mossblaser/makebed/doc/images/testCube.jpg

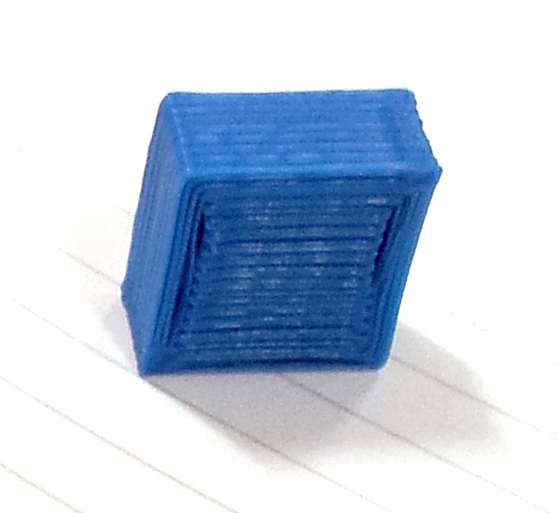
doc/images/testCube.jpg
