mossblaser/makebed/doc/images/testCubeRepg.png

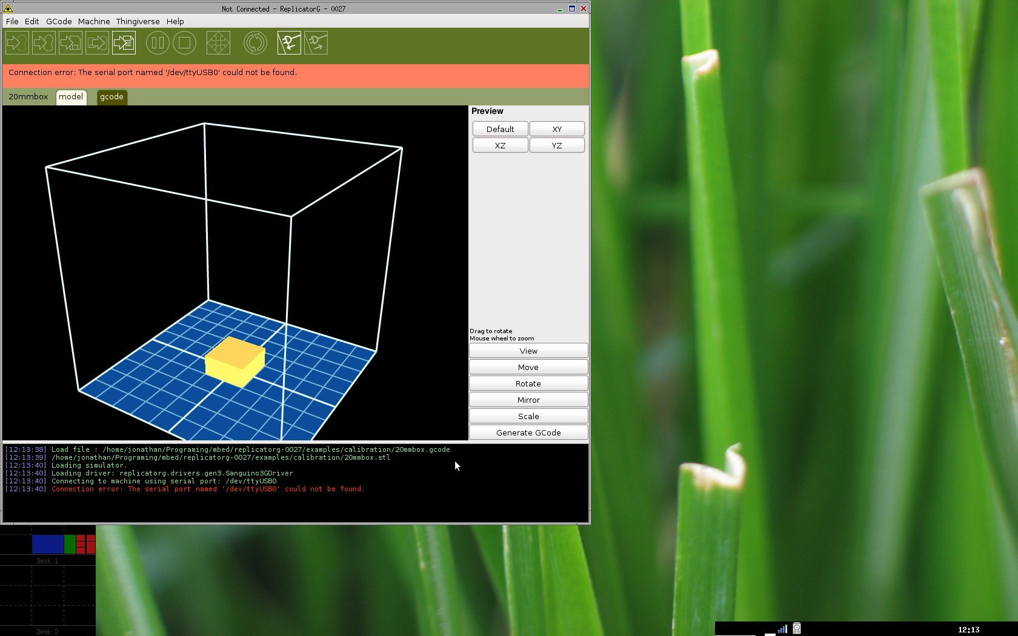
doc/images/testCubeRepg.png
