mossblaser/makebed/doc/diagrams/electronicsDiagram.pdf

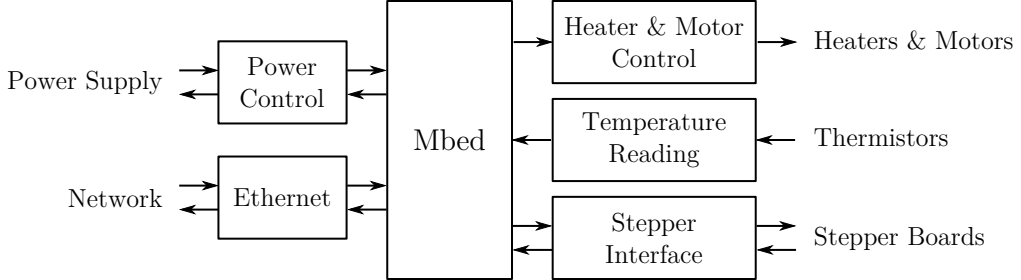
[picture p3: figure]
Mbed; Heater & Motor Control; Temperature Reading; Stepper Interface; Ethernet; Power Control; Power Supply; Network; Heaters & Motors; Thermistors; Stepper Boards
