mossblaser/makebed/doc/diagrams/electronicsPhoto.pdf

ATX Power Supply

Stepper Controller (Z)

Stepper Controller (Y)

Stepper Controller (X)

Ethernet Interface

Programmer Interface

Stop/Reset Button

To Heaters/Motors

To Thermistors

End-stop Board

To End-stops

End-stop Interface

To PSU

Main Board
