mossblaser/makebed/doc/diagrams/datagram.pdf

(UDP Header)

To Printer: | (UDP Header) | Sequence No.
From Printer: | Sequence No. | Window Size Payload (G-code)
