mossblaser/makebed/doc/diagrams/extruder.pdf

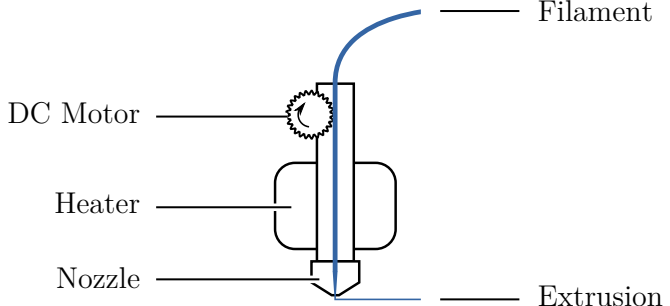
[picture p4: figure]
Filament; DC Motor; Heater; Nozzle; Extrusion
