mossblaser/makebed/doc/diagrams/jackMagnetics.pdf

(A) Without Magnetics | (B) With Magnetics
