mossblaser/makebed/doc/diagrams/mainBoard.pdf

Reserved For
Future Use

Low-Power
Area

High-Power
Area

Passive External
Connections
