mossblaser/makebed/doc/diagrams/stepperControllerBoard.pdf

End-stops

Stepper Motor

TTL Interface

Power
