mossblaser/makebed/doc/diagrams/systemDiagramFirmware.pdf

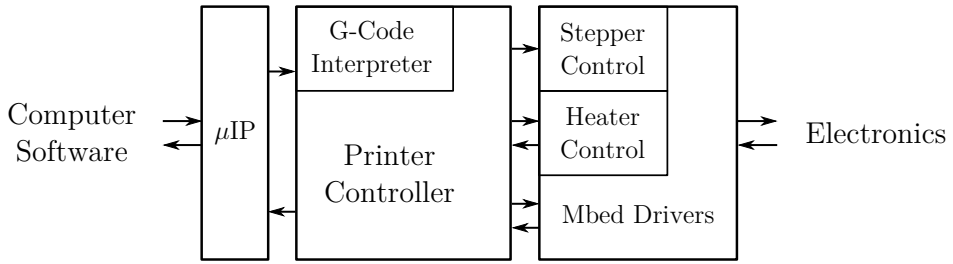
[picture p5: figure]
Printer Controller; G-Code Interpreter; µIP; Mbed Drivers; Stepper Control; Heater Control; Computer; Software; Electronics
