mossblaser/makebed/doc/diagrams/timerArch.pdf

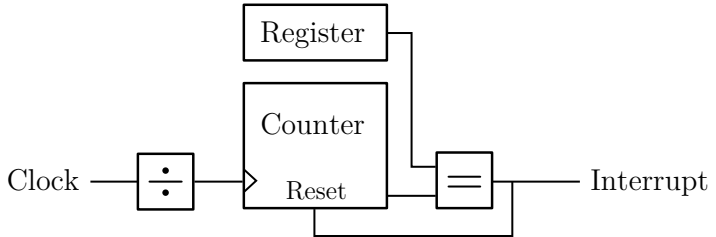
[picture p6: figure]
Clock; Counter; Register; Reset; Interrupt
