mossblaser/makebed/doc/report.tex

\documentclass[twoside,a4paper,12pt]{third-rep}

\newcommand{\uIP}{$\mu{}$IP}
\newcommand{\mm}{\textrm{mm}}
\newcommand{\cm}{\textrm{cm}}
\newcommand{\s}{\textrm{s}}
\newcommand{\minute}{\textrm{minute}}
\newcommand{\us}{\mu\textrm{s}}
\newcommand{\ms}{\textrm{ms}}
\newcommand{\Hz}{\textrm{Hz}}
\newcommand{\kHz}{\textrm{kHz}}
\newcommand{\MHz}{\textrm{MHz}}
\newcommand{\KB}{\textrm{KB}}
\newcommand{\dC}{\ensuremath{^\circ\textrm{C}}}

\newenvironment{gcoderegs}%
{\vspace{\itemsep}\hspace{\stretch{1}}}%
{\hspace{\stretch{1}}\vspace{\itemsep}}
\newcommand{\reg}[2]{\textbf{#1:}\hspace{1ex}$#2$\hspace{1.5em}}

% Don't split footnotes over multiple pages!
\interfootnotelinepenalty=10000

% Get rid of some orphans
\widowpenalty=300
\clubpenalty=300

%\includeonly{chapter1}

\usepackage{url}
\usepackage{verbatim}
\usepackage{booktabs}
\usepackage{float}
\usepackage{pdflscape}

\title{Improving the Makerbot 3D Printer}
\author{Jonathan Heathcote}
\supervisor{Alasdair Rawsthorne}
\reportyear{2012}

%% this defines the file that contains the text of the abstract, there
%% must be one of these by the time you submit your report.
\abstractfile{abstract.tex}

%% this defines the file that contains the acknowledgements (it can be
%% omitted if you don't feel like thanking anyone
\thanksfile{thanks.tex}

% Uncomment the following line if you want to change the name of the
% Bibliography to References
\renewcommand{\bibname}{References}

%%%%%%%%%%%%%%%%%%%%%%%%%%%%%%%%%%%%%%%%%%%%%%%%%%%%%%%%%%%%%%%%%%%%%%%%%%%%%%%%

\begin{document}
	% Front matter
	\dotitleandabstract
	
	\tableofcontents
	\listoffigures
	\listoftables
 
	% Chapters
	\include{chapter1}
	\include{chapter2}
	\include{chapter3}
	\include{chapter4}
	\include{chapter5}
	\include{chapter6}
	
	% End matter
	\bibliography{refs}
	
	% this determines the style in which the references are printed, other
	% possible values are plain and abbrv
	\bibliographystyle{alpha}
	
	% Appendices
	\appendix
	\include{appendix1}
	\include{appendix2}
	\include{appendix3}
	\include{appendix4}
	\include{appendix5}
	\include{appendix6}
\end{document}
