mossblaser/makebed/doc/diagrams/adc.pdf

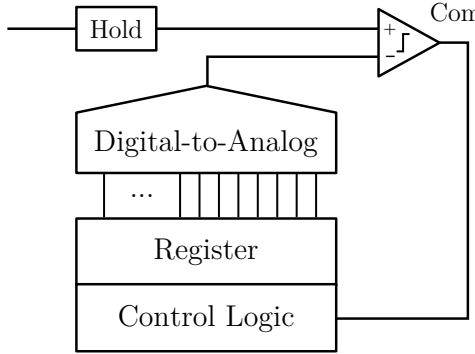
[picture p7: figure]
Register; Digital-to-Analog; Control Logic

Comparator
Analog-In | Hold
