mossblaser/makebed/doc/images/breadboard.jpg

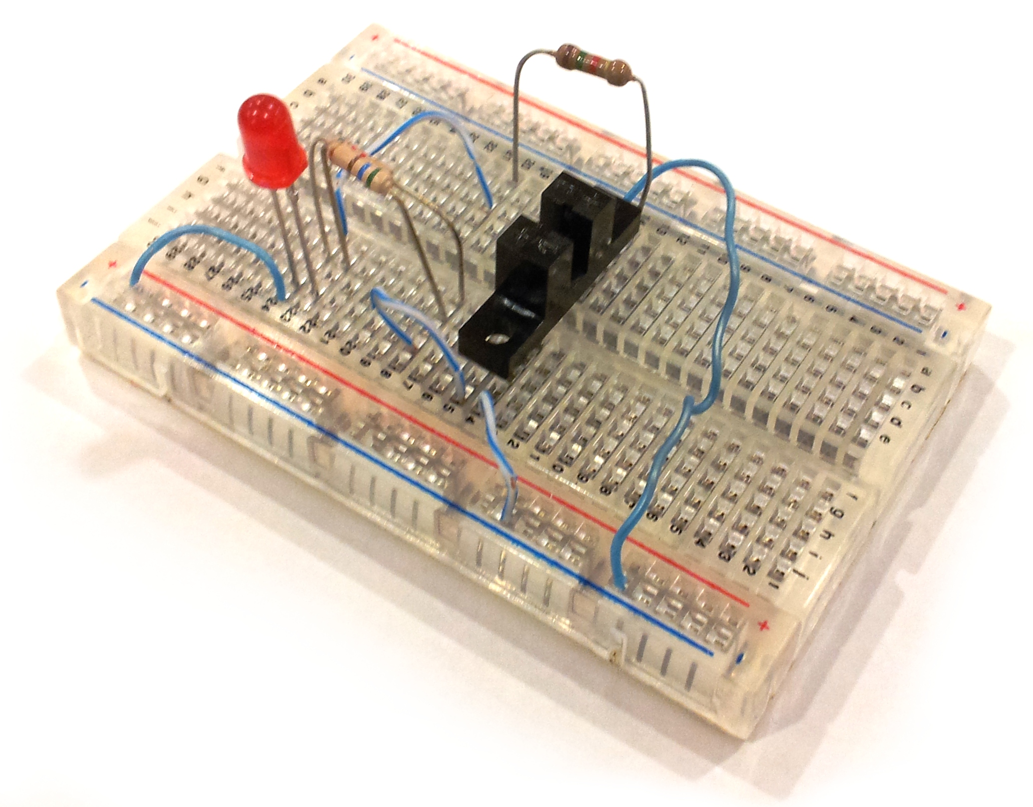
doc/images/breadboard.jpg
