mossblaser/makebed/doc/images/butterfly.jpg

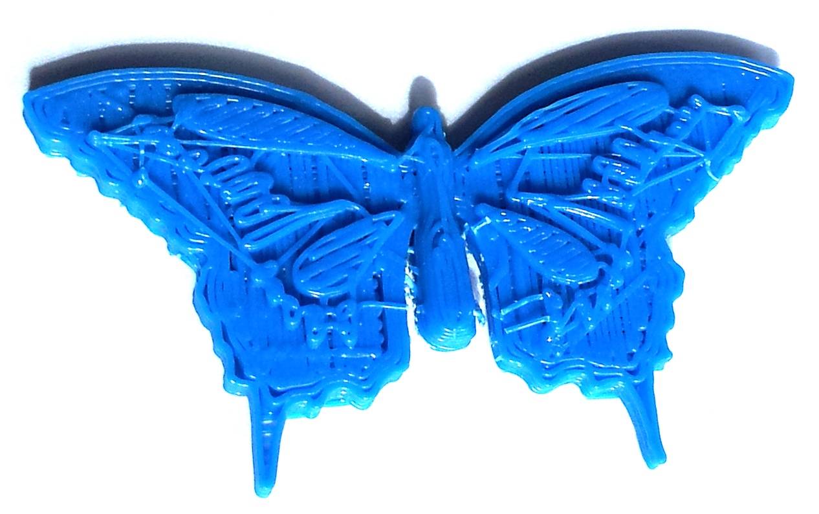
doc/images/butterfly.jpg
