mossblaser/makebed/doc/images/butterflyShot.png

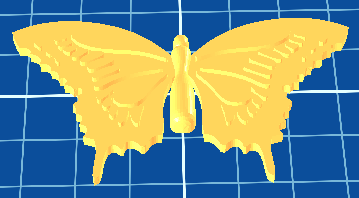
doc/images/butterflyShot.png
