mossblaser/makebed/doc/images/calipers.jpg

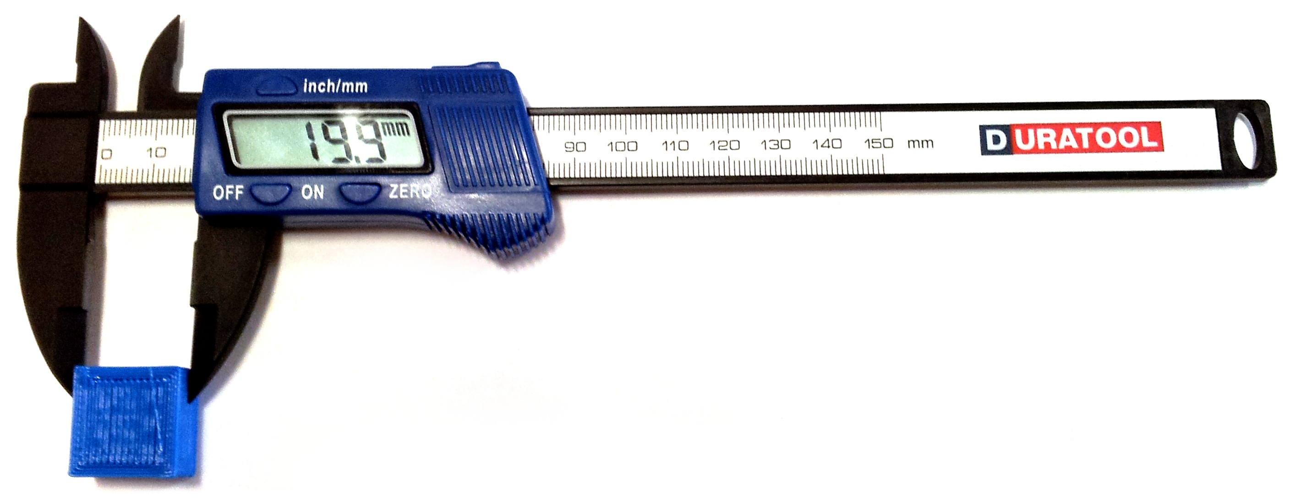
doc/images/calipers.jpg
