mossblaser/makebed/doc/images/comb.jpg

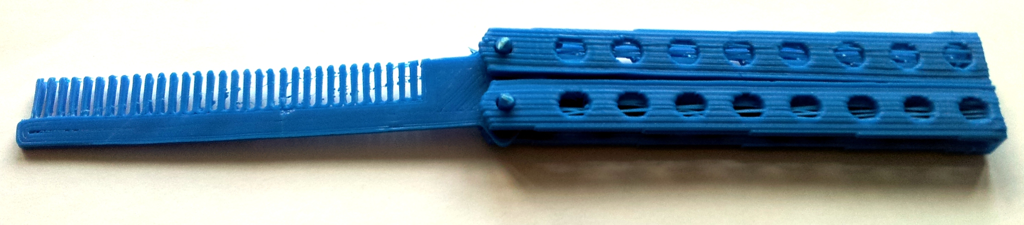
doc/images/comb.jpg
