mossblaser/makebed/doc/images/disk.jpg

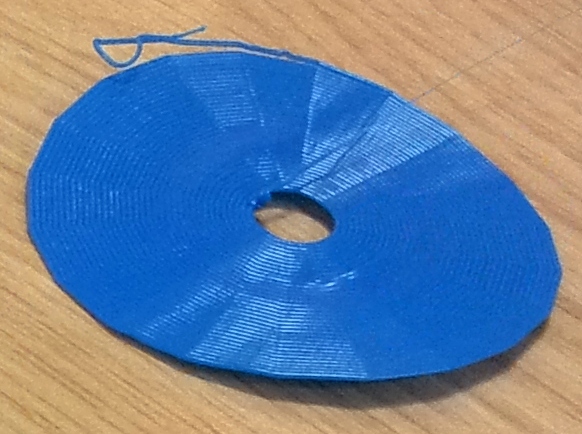
doc/images/disk.jpg
