mossblaser/makebed/doc/images/doorstop.jpg

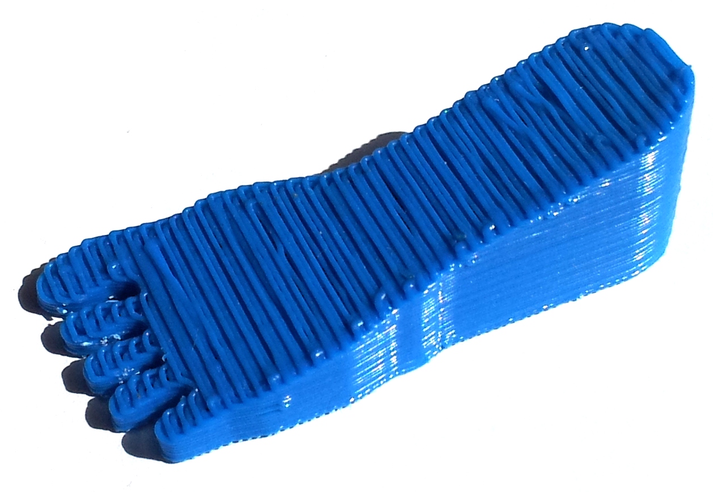
doc/images/doorstop.jpg
