mossblaser/makebed/doc/images/doorstopShot.png

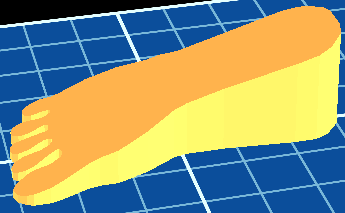
doc/images/doorstopShot.png
