mossblaser/makebed/doc/images/eject.jpg

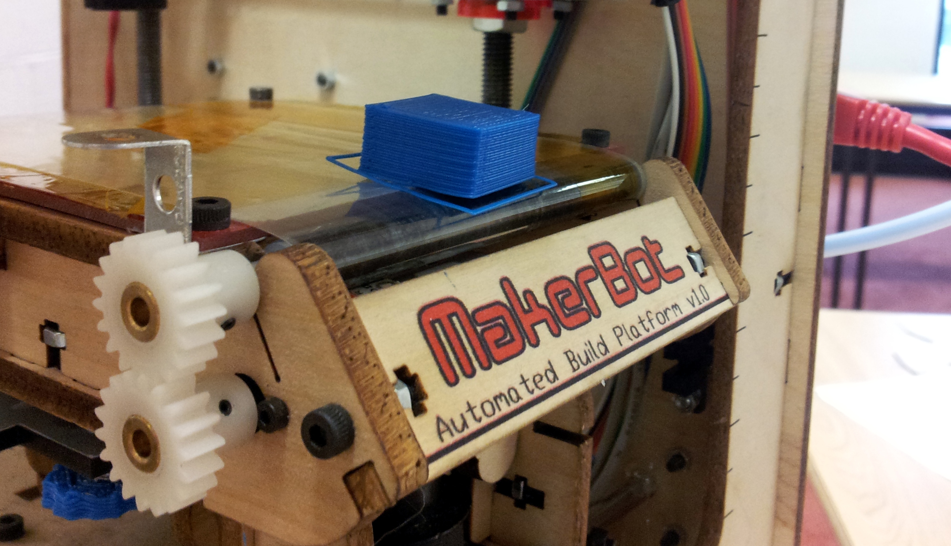
doc/images/eject.jpg
