mossblaser/makebed/doc/images/electronicsPhoto.jpg

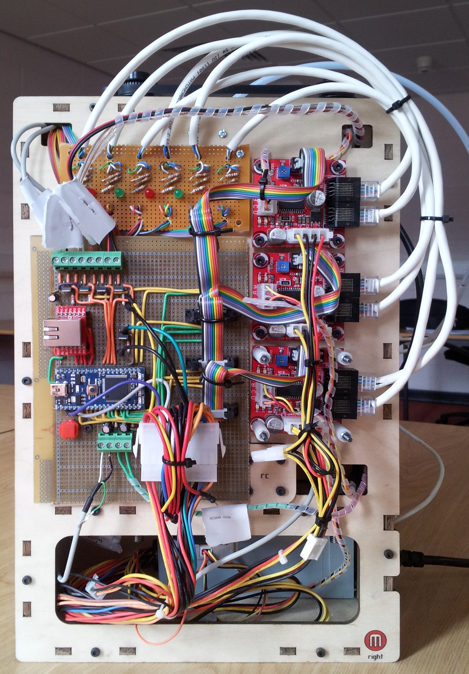
doc/images/electronicsPhoto.jpg
