mossblaser/makebed/doc/images/endstop.jpg

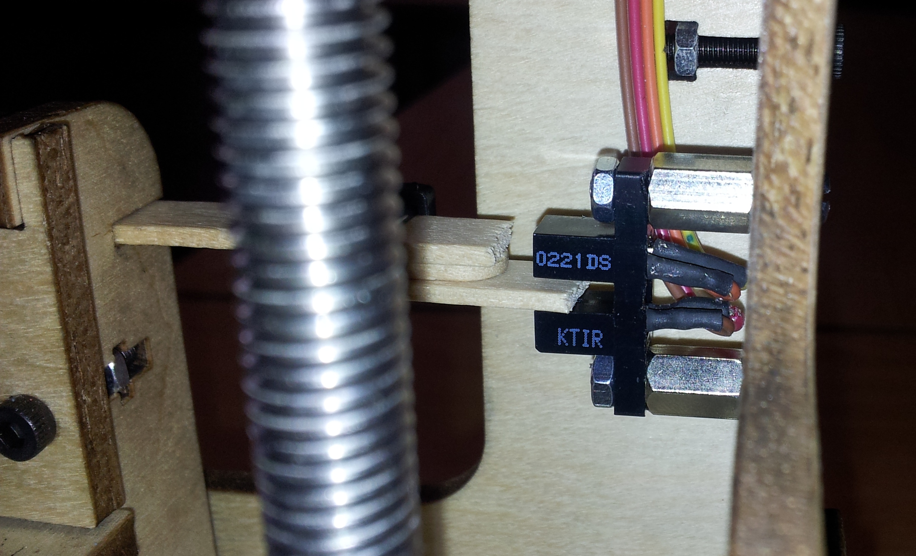
doc/images/endstop.jpg
