mossblaser/makebed/doc/images/exampleCube.jpg

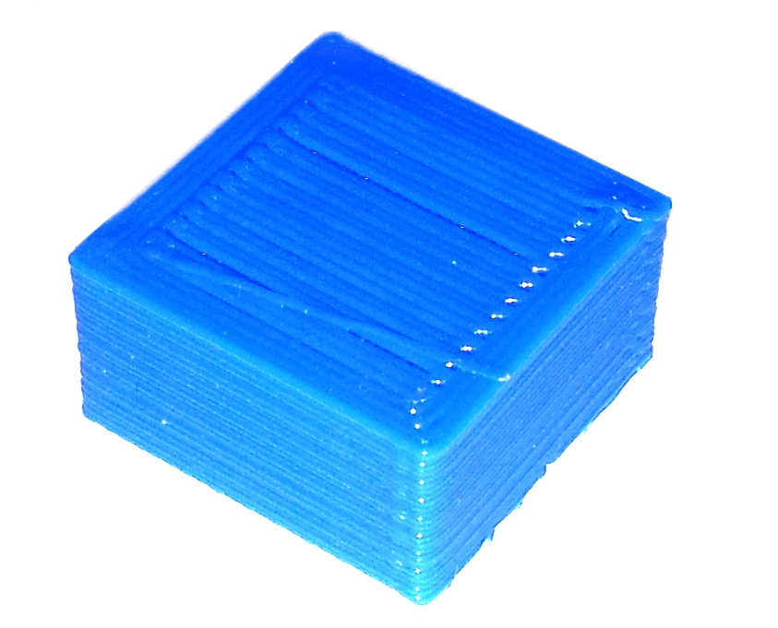
doc/images/exampleCube.jpg
