mossblaser/makebed/doc/images/fillPattern.jpg

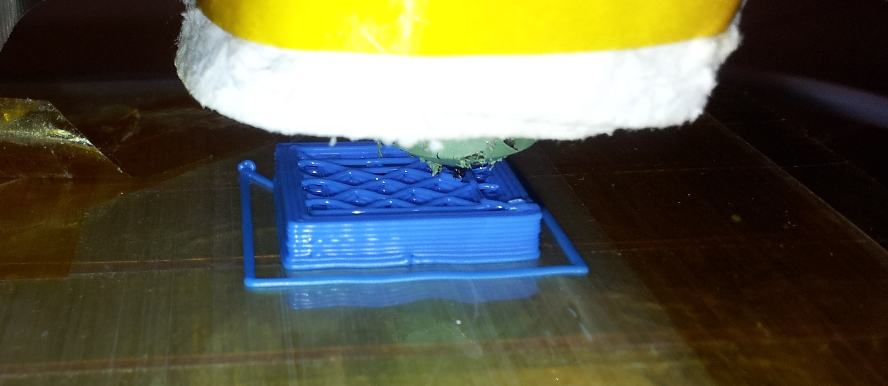
doc/images/fillPattern.jpg
