mossblaser/makebed/doc/images/firstLayer.jpg

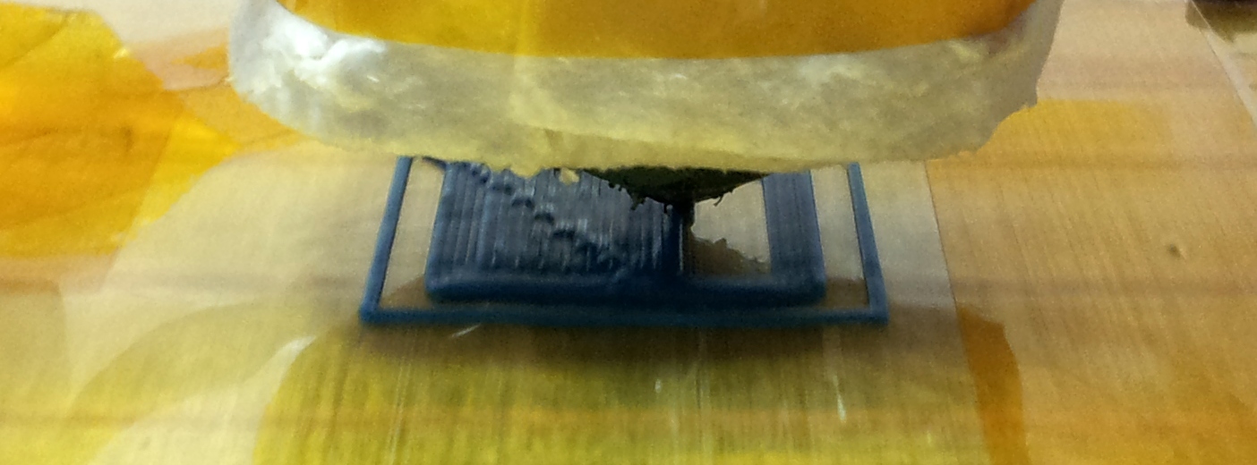
doc/images/firstLayer.jpg
