mossblaser/makebed/doc/images/gearCube.jpg

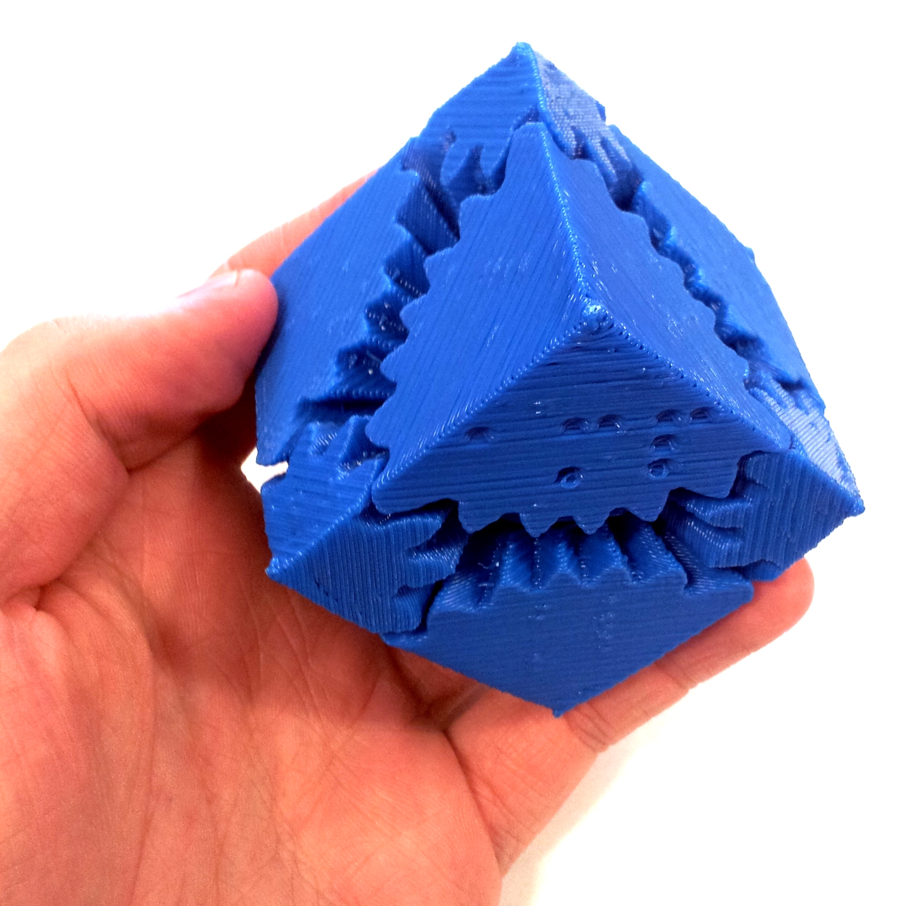
doc/images/gearCube.jpg
