mossblaser/makebed/doc/images/gearCubeOpen.jpg

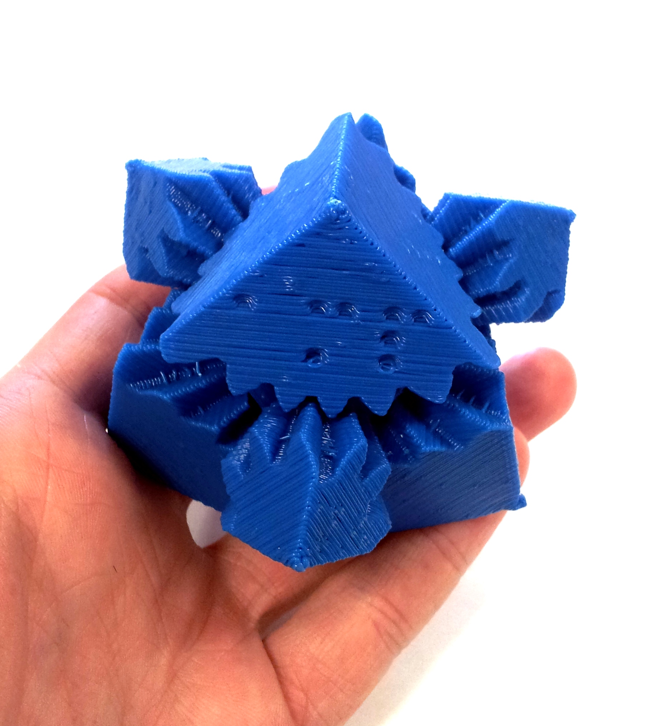
doc/images/gearCubeOpen.jpg
