mossblaser/makebed/doc/images/handle.jpg

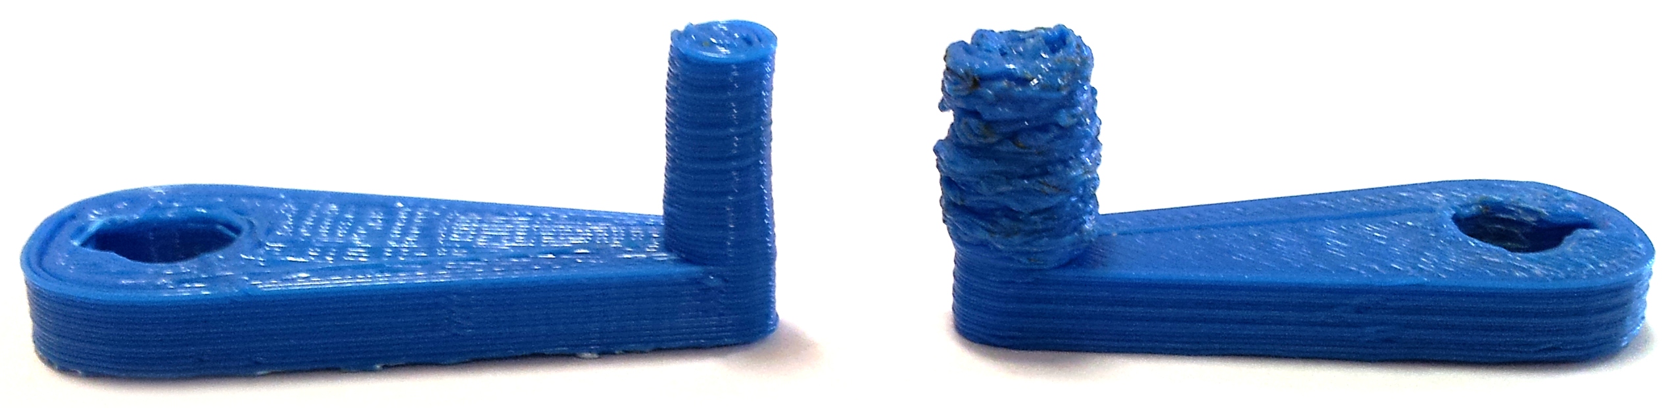
doc/images/handle.jpg
