mossblaser/makebed/doc/images/heartClosed.jpg

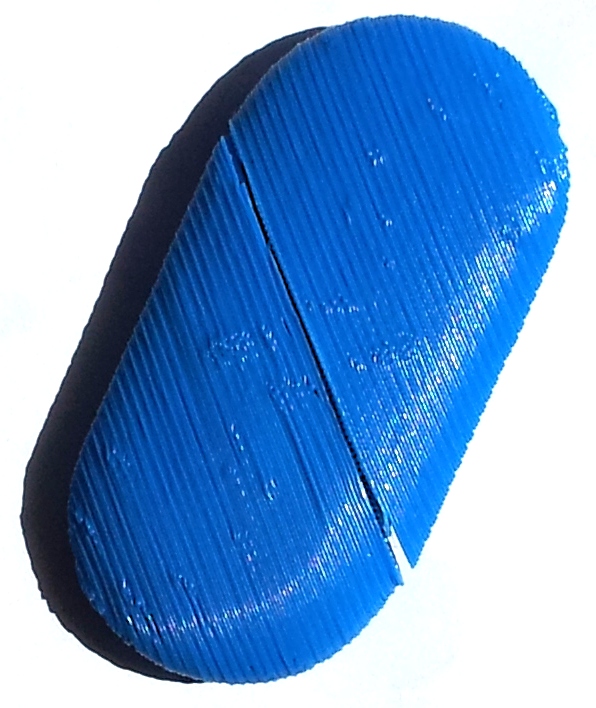
doc/images/heartClosed.jpg
