mossblaser/makebed/doc/images/heartHalfShot.png

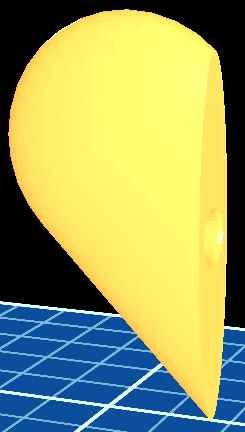
doc/images/heartHalfShot.png
