mossblaser/makebed/doc/images/heartShape.jpg

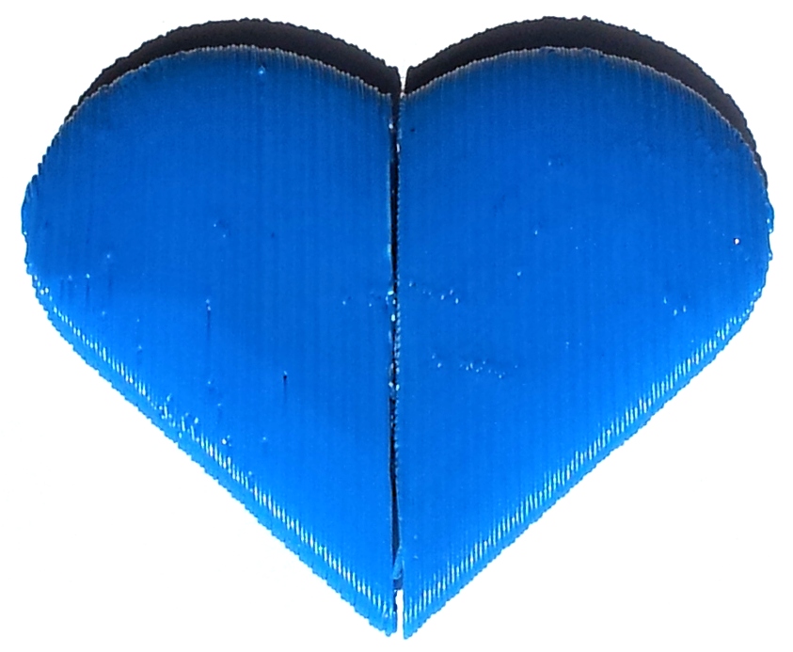
doc/images/heartShape.jpg
