mossblaser/makebed/doc/images/herringboneSide.jpg

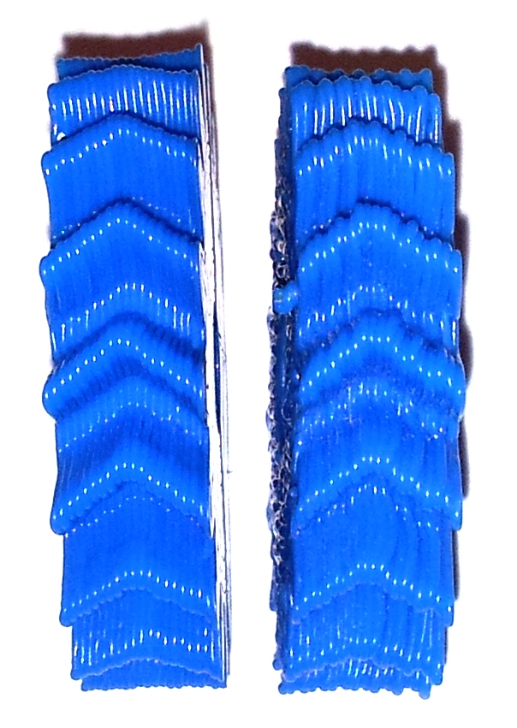
doc/images/herringboneSide.jpg
