mossblaser/makebed/doc/images/herringboneTop.jpg

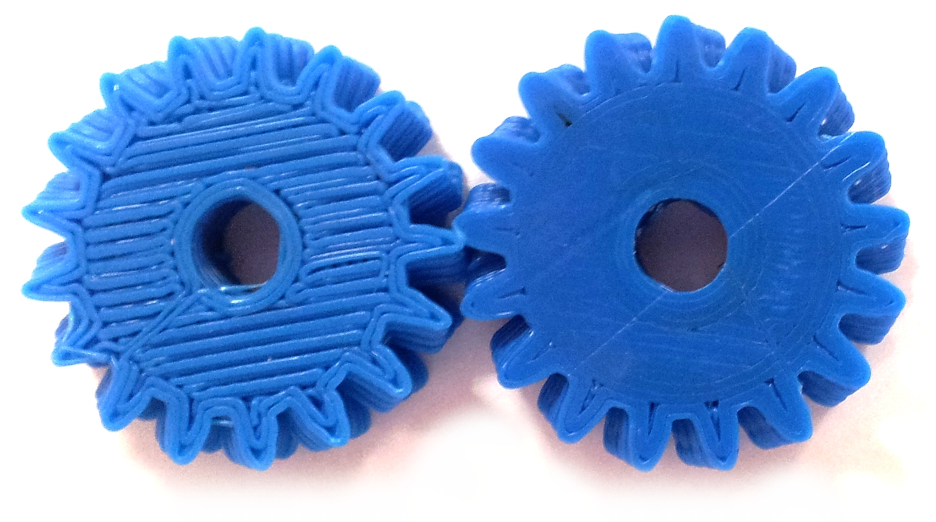
doc/images/herringboneTop.jpg
