mossblaser/makebed/doc/images/highSpiral.jpg

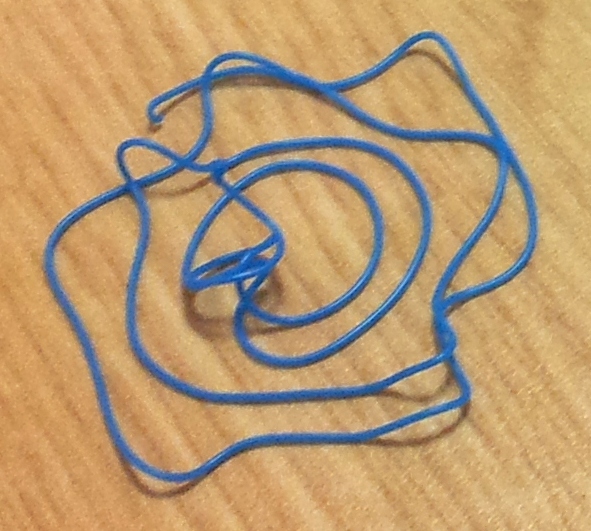
doc/images/highSpiral.jpg
