mossblaser/makebed/doc/images/homing.jpg

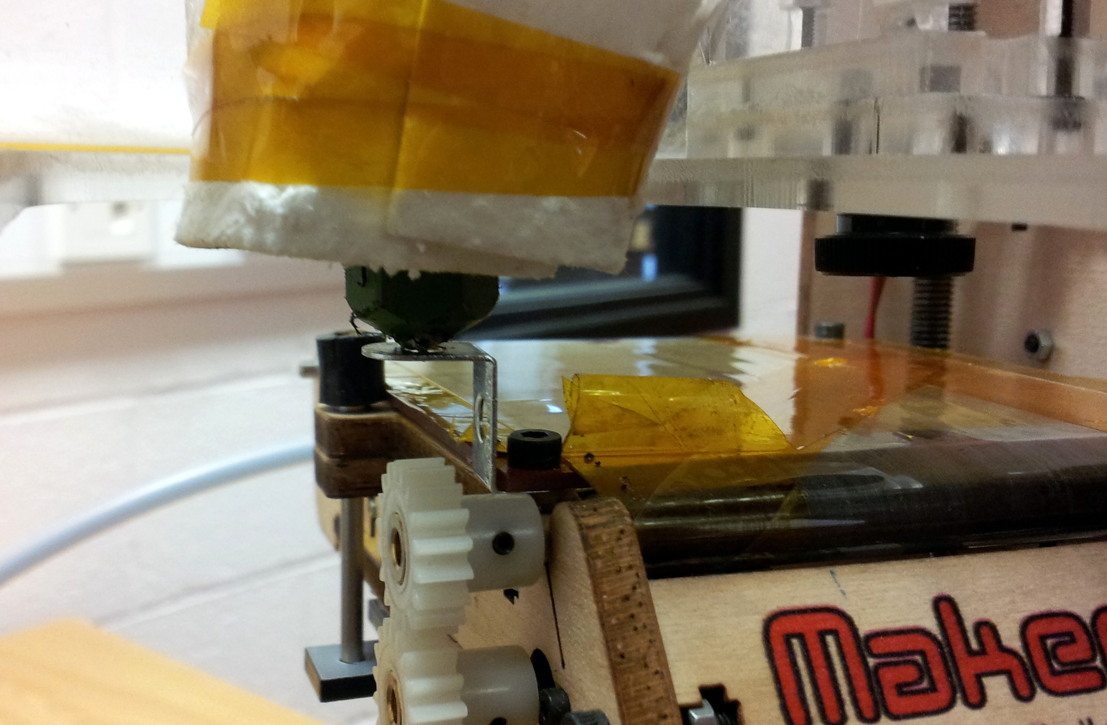
doc/images/homing.jpg
