mossblaser/makebed/doc/images/jackMagnetics.jpg

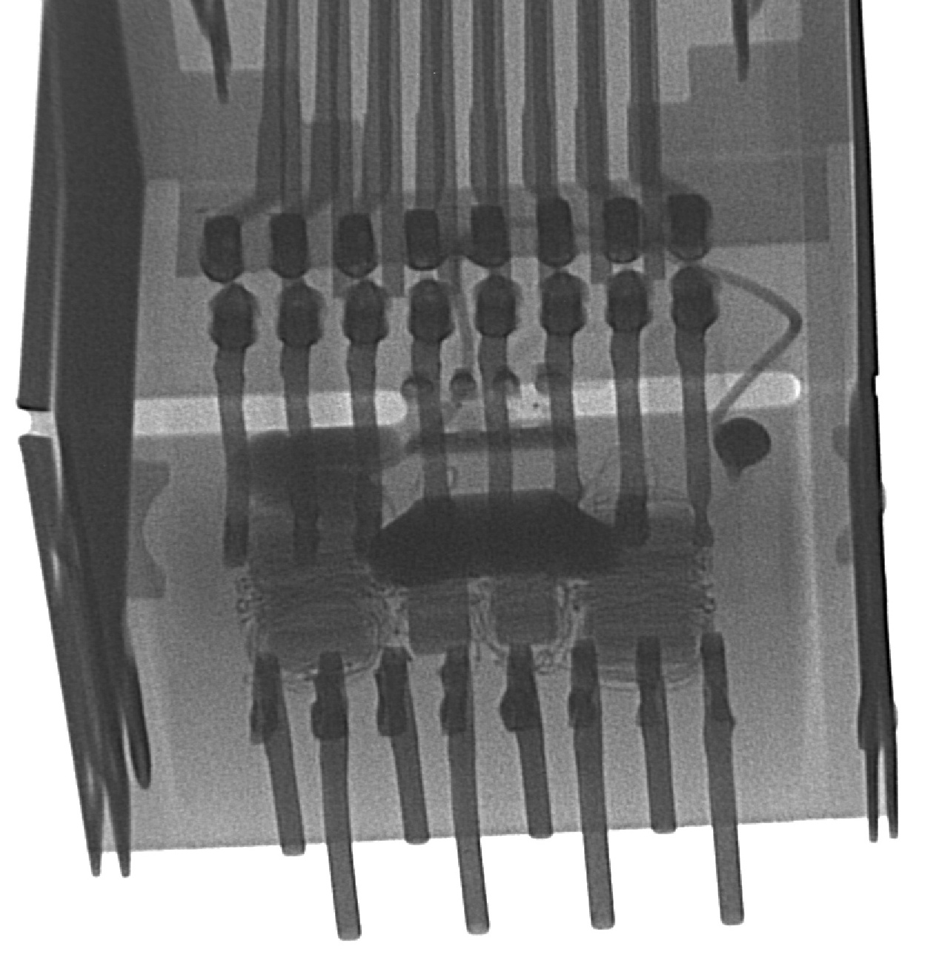
doc/images/jackMagnetics.jpg
