mossblaser/makebed/doc/images/jackNoMagnetics.jpg

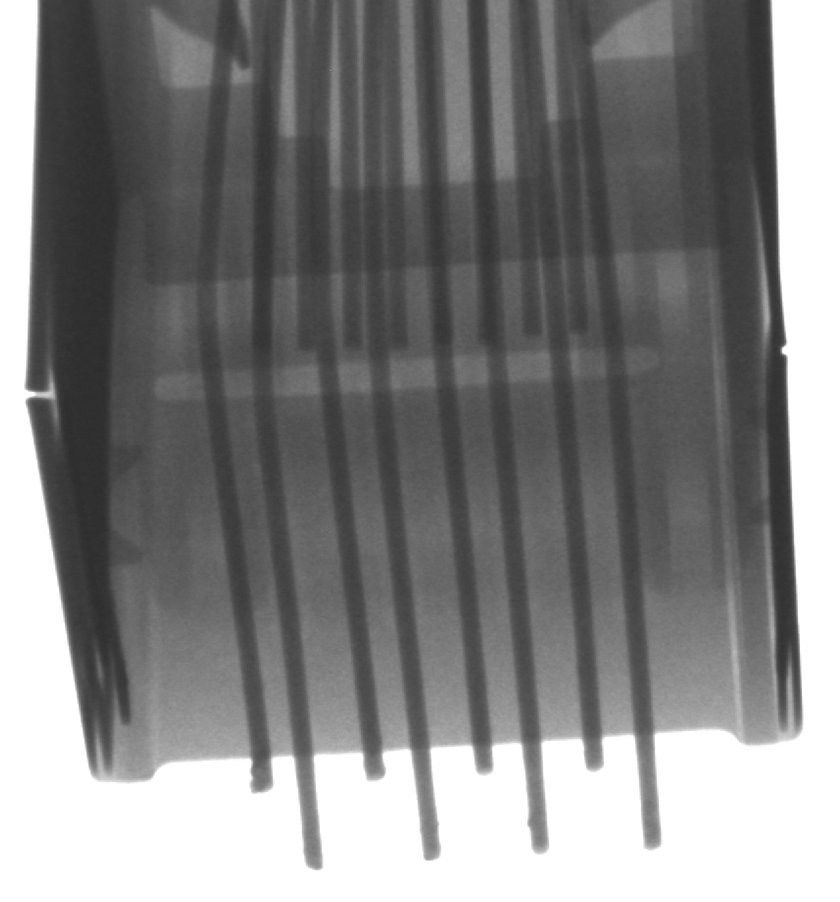
doc/images/jackNoMagnetics.jpg
