mossblaser/makebed/doc/images/jobLot.jpg

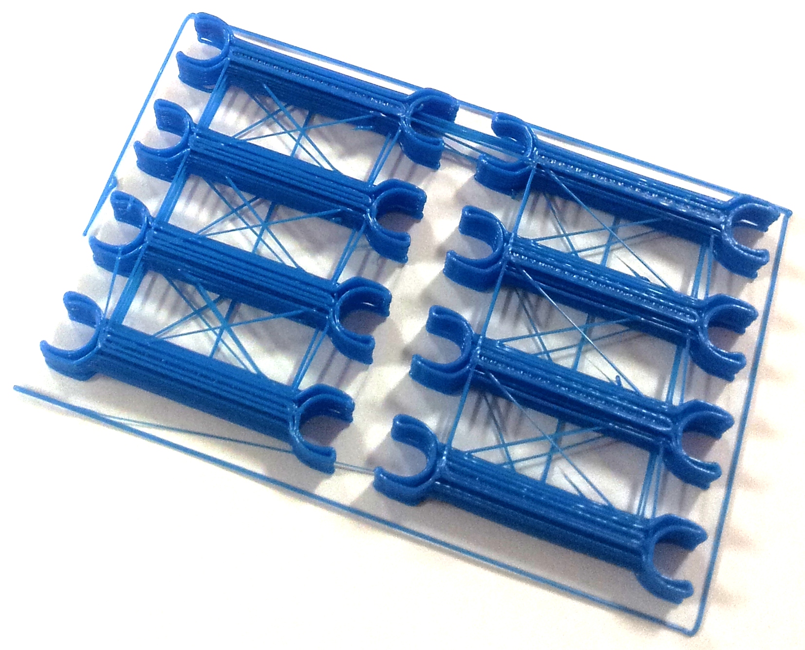
doc/images/jobLot.jpg
