mossblaser/makebed/doc/images/jobLot.png

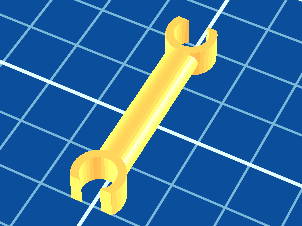
doc/images/jobLot.png
