mossblaser/makebed/doc/images/letter.jpg

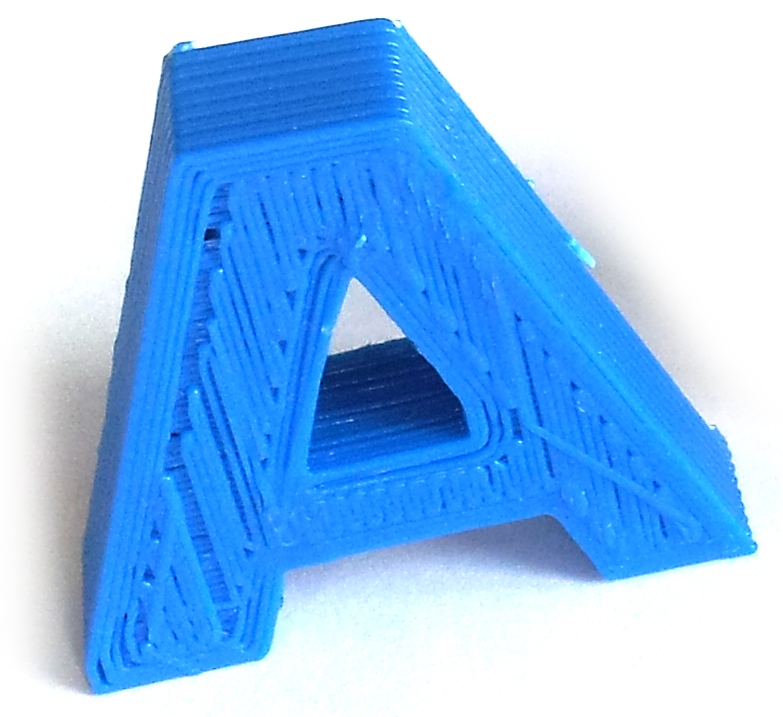
doc/images/letter.jpg
