mossblaser/makebed/doc/images/letterShot.png

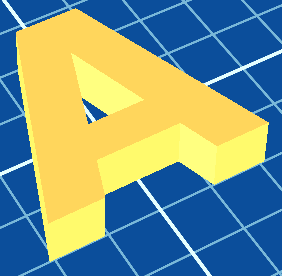
doc/images/letterShot.png
