mossblaser/makebed/doc/images/looseSpiral.jpg

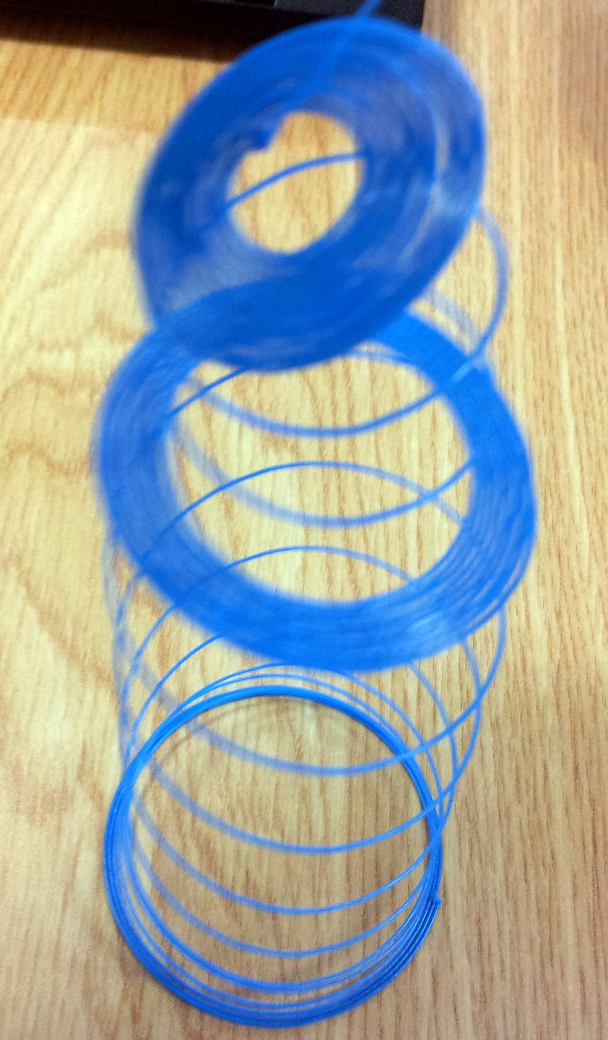
doc/images/looseSpiral.jpg
