mossblaser/makebed/doc/images/lowLargeSpiral.jpg

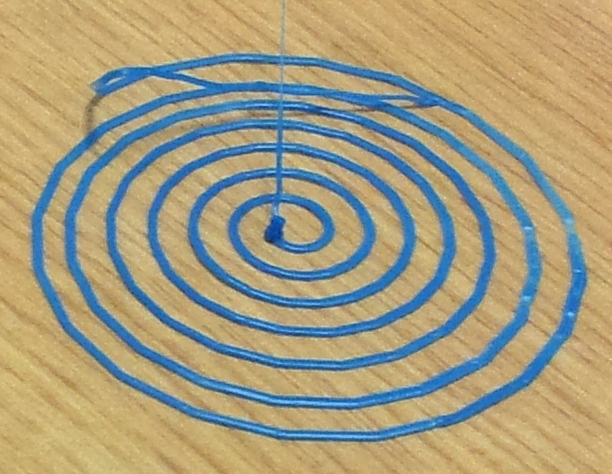
doc/images/lowLargeSpiral.jpg
