mossblaser/makebed/doc/images/lowSpiral.jpg

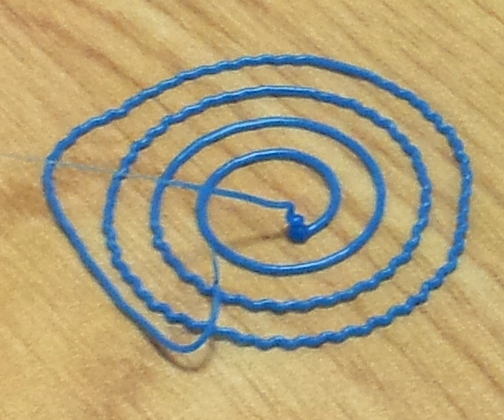
doc/images/lowSpiral.jpg
