mossblaser/makebed/doc/images/mainBoardTop.jpg

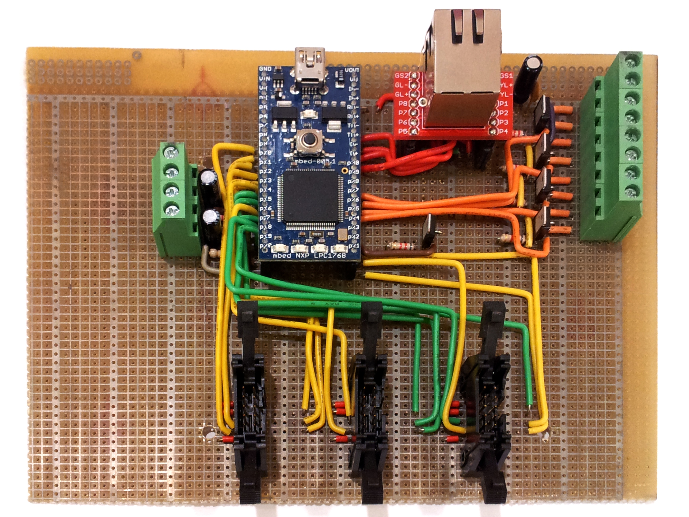
doc/images/mainBoardTop.jpg
