mossblaser/makebed/doc/images/mbed.jpg

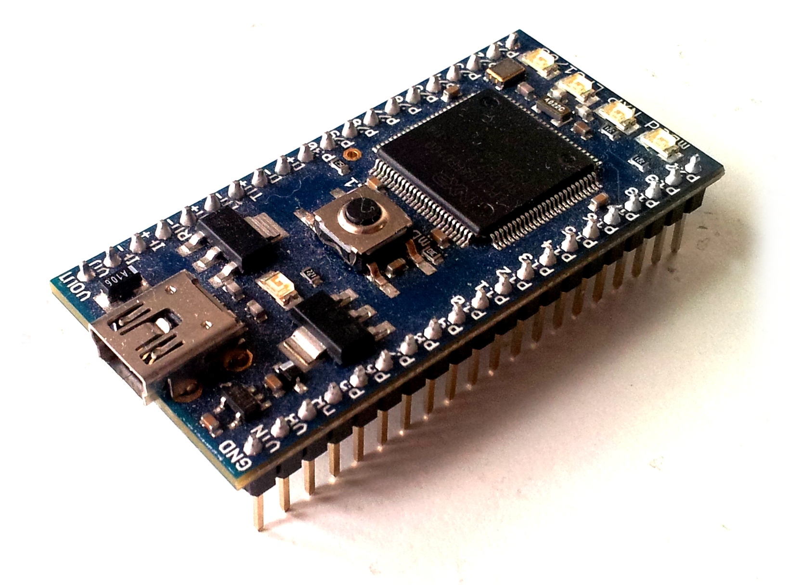
doc/images/mbed.jpg
