mossblaser/makebed/doc/images/openSCAD.png

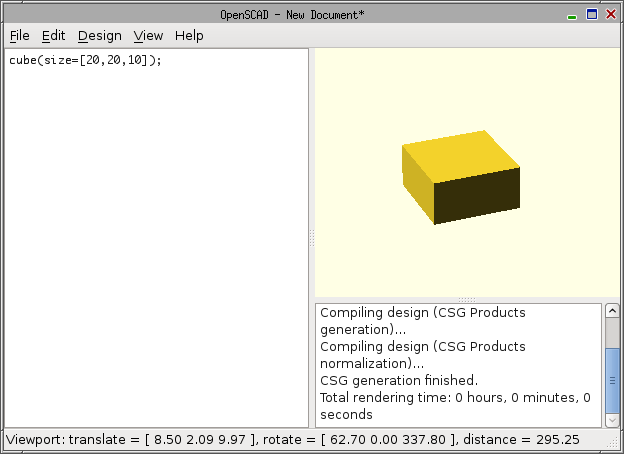
doc/images/openSCAD.png
