mossblaser/makebed/doc/images/phoneDock.jpg

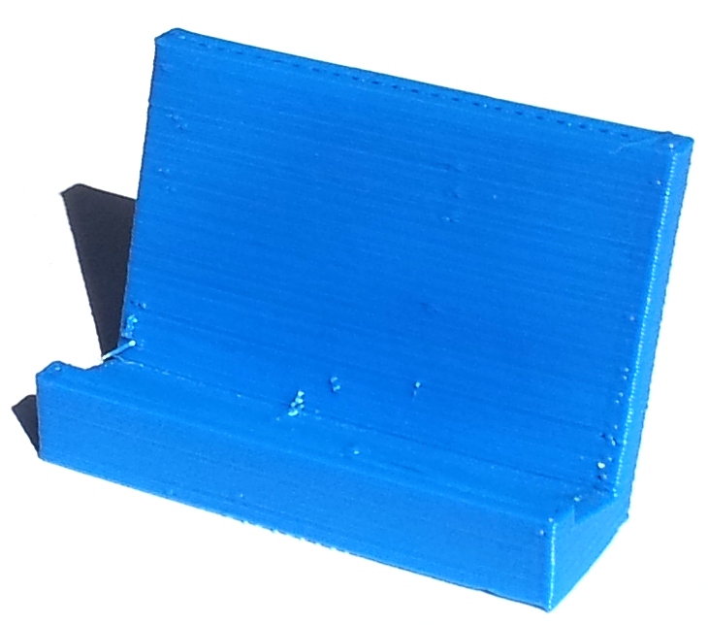
doc/images/phoneDock.jpg
