mossblaser/makebed/doc/images/phoneDockShot.png

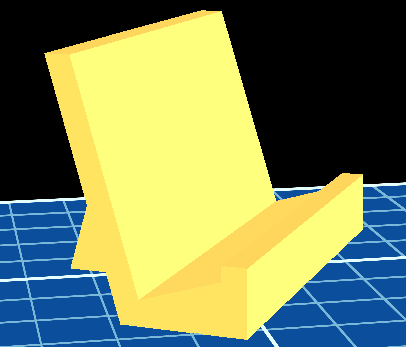
doc/images/phoneDockShot.png
