mossblaser/makebed/doc/images/rabbit.jpg

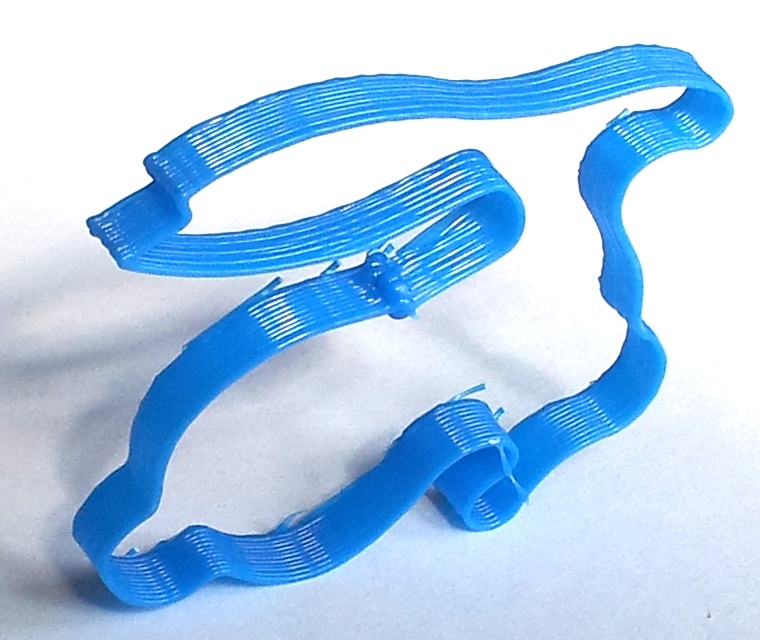
doc/images/rabbit.jpg
