mossblaser/makebed/doc/images/rabbitShot.png

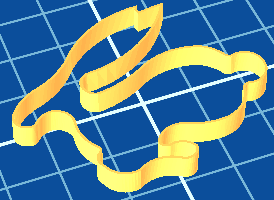
doc/images/rabbitShot.png
