mossblaser/makebed/doc/images/replicatorG.png

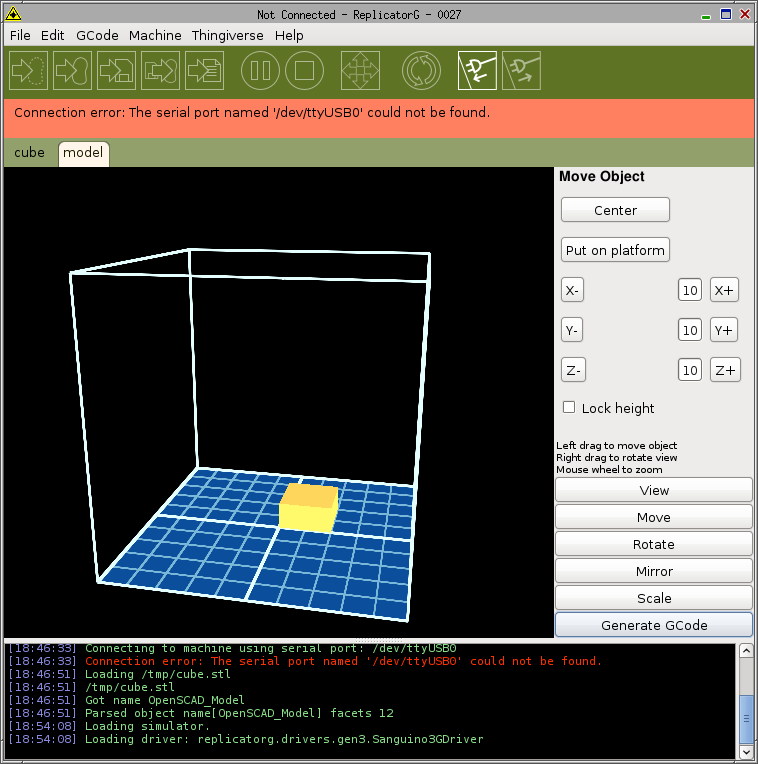
doc/images/replicatorG.png
