mossblaser/makebed/doc/images/selfClean.jpg

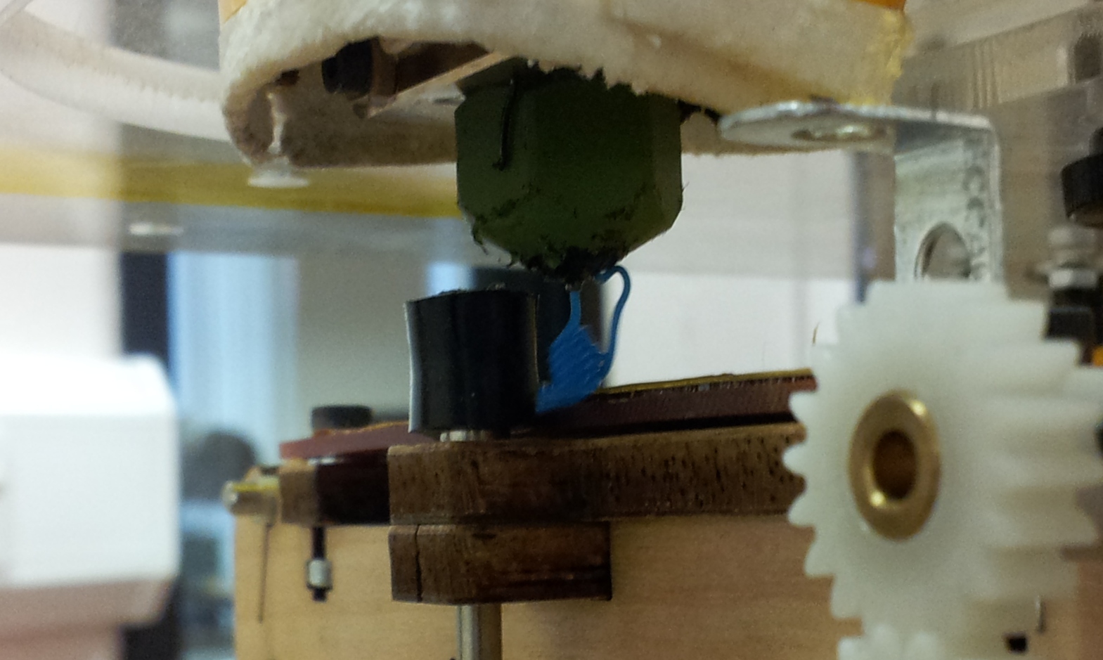
doc/images/selfClean.jpg
