mossblaser/makebed/doc/images/skeinforge.png

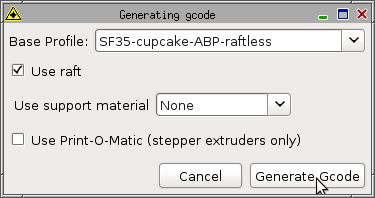
doc/images/skeinforge.png
