mossblaser/makebed/doc/images/snake.jpg

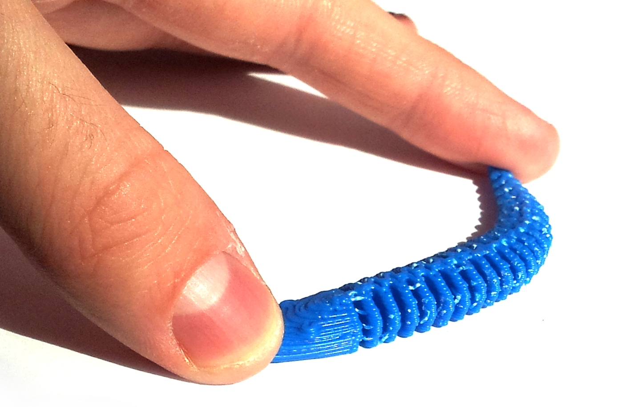
doc/images/snake.jpg
