mossblaser/makebed/doc/images/snakeShot.png

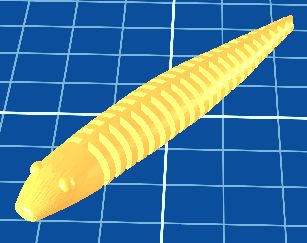
doc/images/snakeShot.png
