mossblaser/makebed/doc/images/starfish.jpg

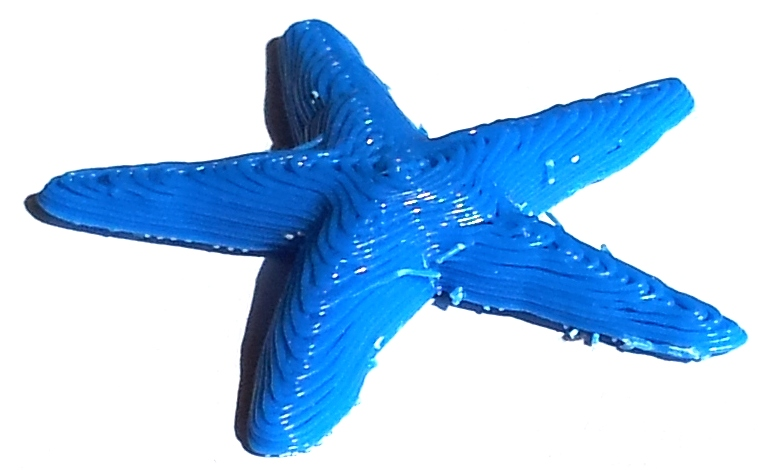
doc/images/starfish.jpg
