mossblaser/makebed/doc/images/starfishShot.png

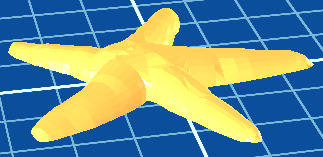
doc/images/starfishShot.png
