mossblaser/makebed/doc/images/stop.jpg

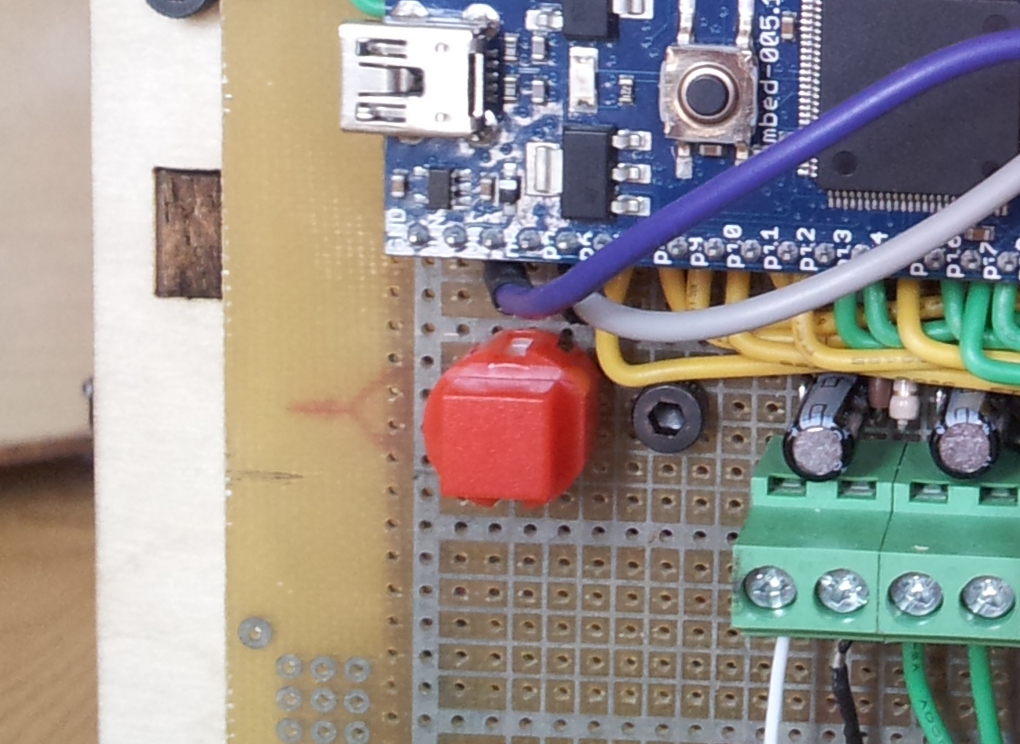
doc/images/stop.jpg
