mossblaser/makebed/doc/images/stringing.jpg

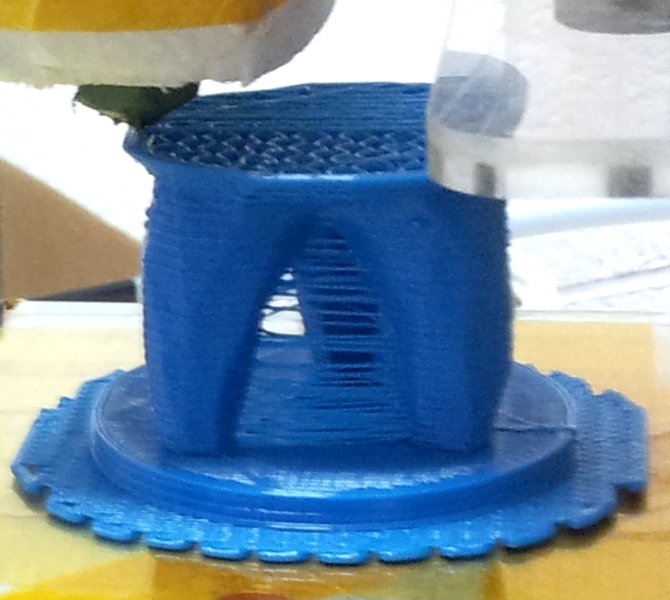
doc/images/stringing.jpg
