mossblaser/makebed/doc/images/thermometer.jpg

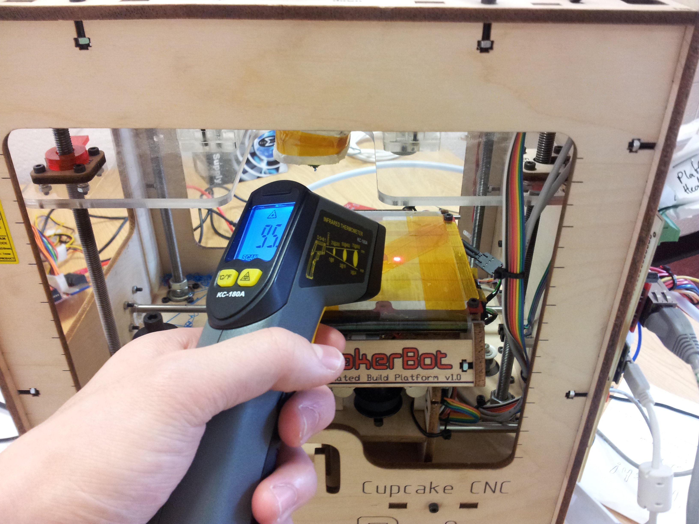
doc/images/thermometer.jpg
