mossblaser/makebed/doc/images/tooth.jpg

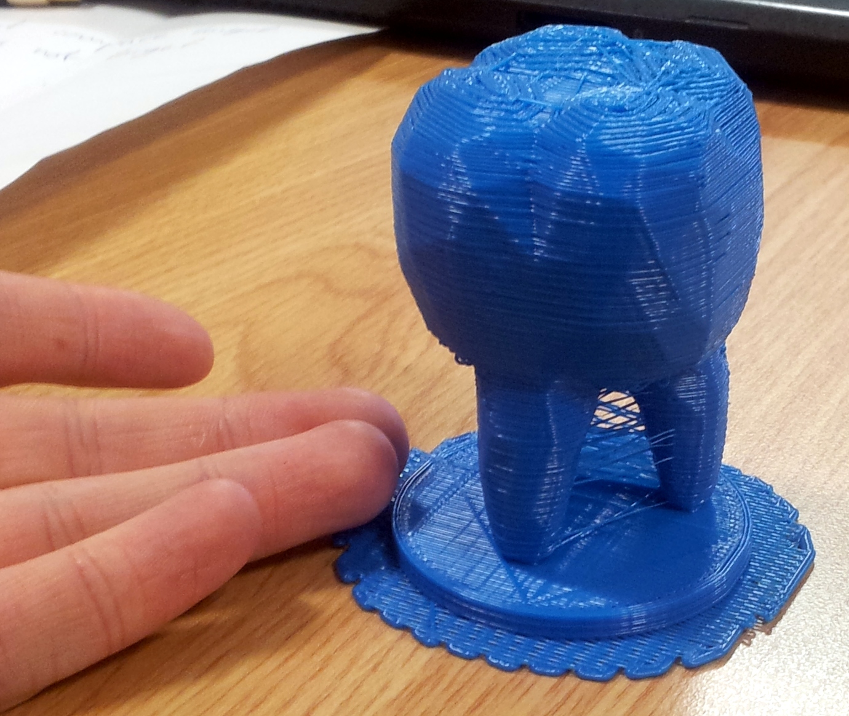
doc/images/tooth.jpg
