mossblaser/makebed/doc/images/toothShot.png

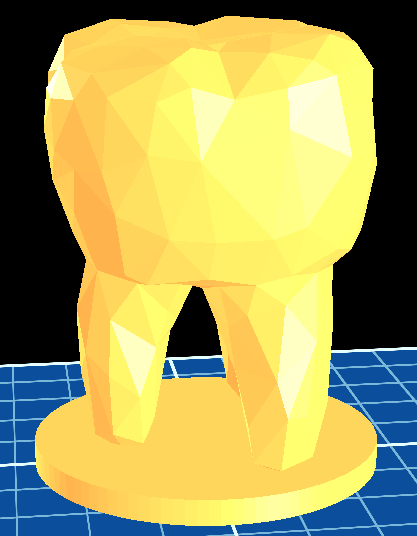
doc/images/toothShot.png
