mossblaser/makebed/doc/images/tweezers.jpg

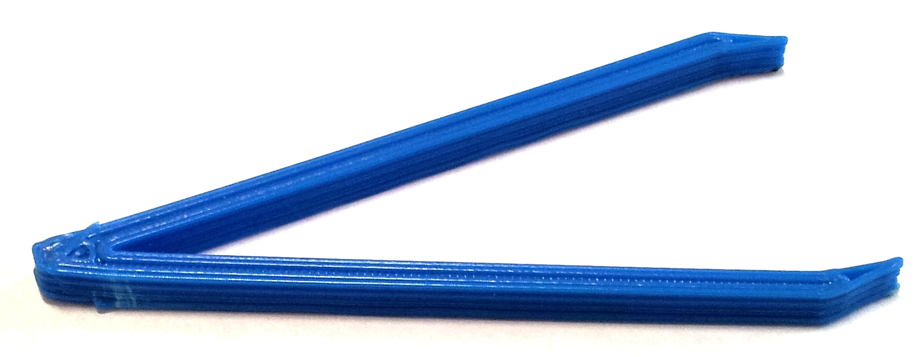
doc/images/tweezers.jpg
