mossblaser/makebed/doc/images/tweezersShot.png

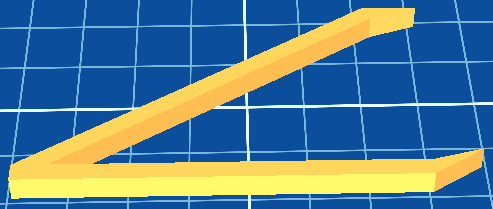
doc/images/tweezersShot.png
