mossblaser/makebed/doc/images/vase.jpg

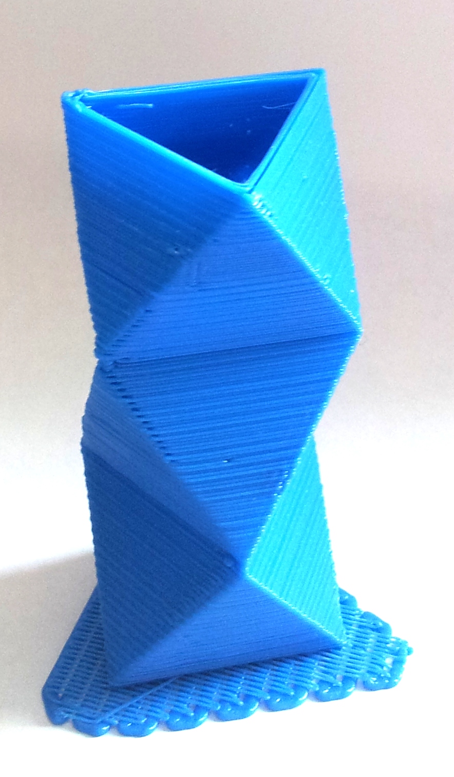
doc/images/vase.jpg
