mossblaser/makebed/doc/images/vaseRepg.png

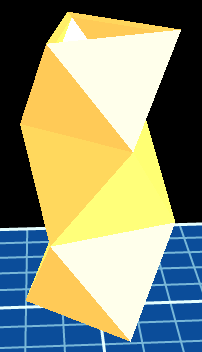
doc/images/vaseRepg.png
