mossblaser/makebed/doc/images/whistle.jpg

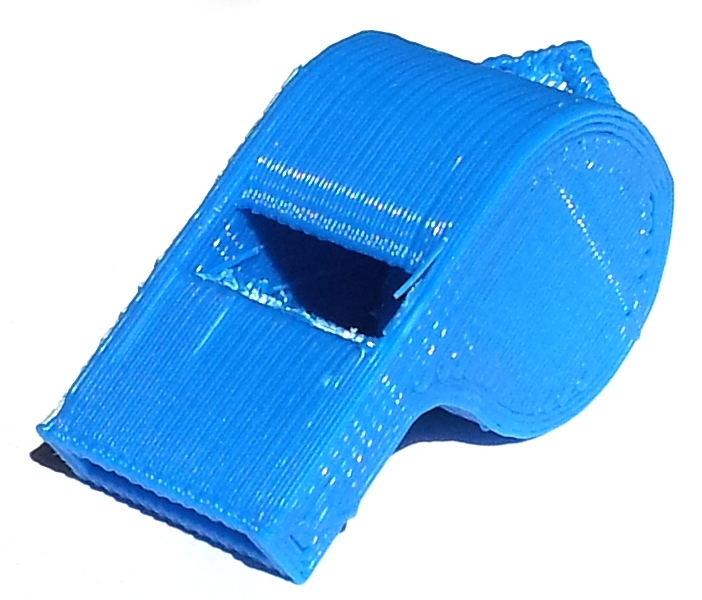
doc/images/whistle.jpg
