mossblaser/makebed/doc/images/whistleShot.png

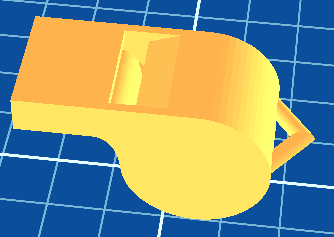
doc/images/whistleShot.png
