mossblaser/makebed/doc/images/heartParts.jpg

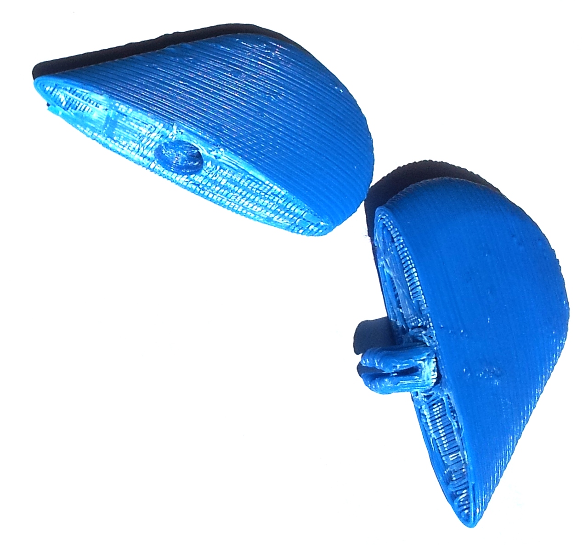
doc/images/heartParts.jpg
