mossblaser/makebed/doc/diagrams/mosfetUsage.pdf

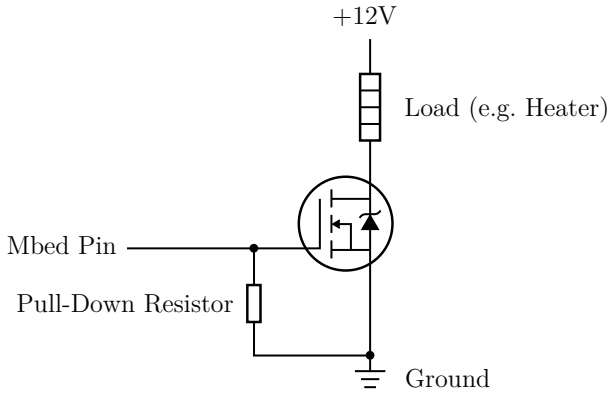
[picture p67: figure]
Mbed Pin; Load (e.g. Heater); Ground; Pull-Down Resistor
