mossblaser/makebed/doc/diagrams/printerBasics.pdf

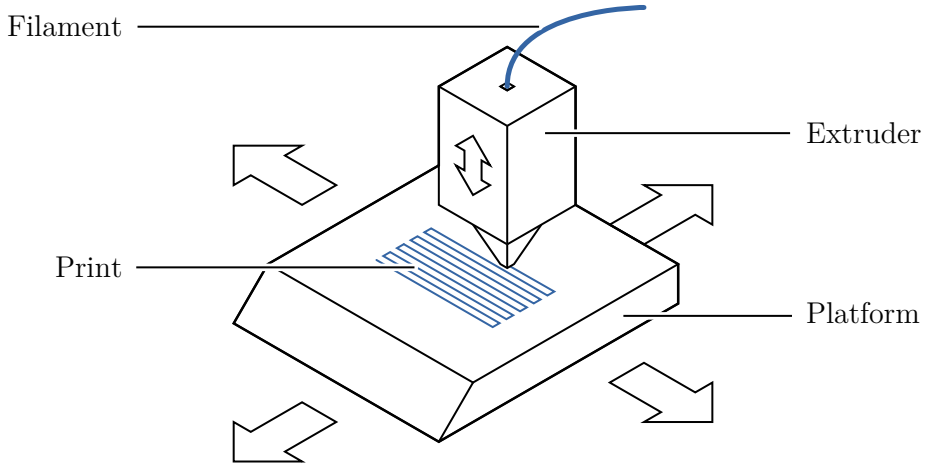
[picture p68: figure]
Extruder; Platform; Filament; Print
