mossblaser/makebed/doc/images/failedPrint.jpg

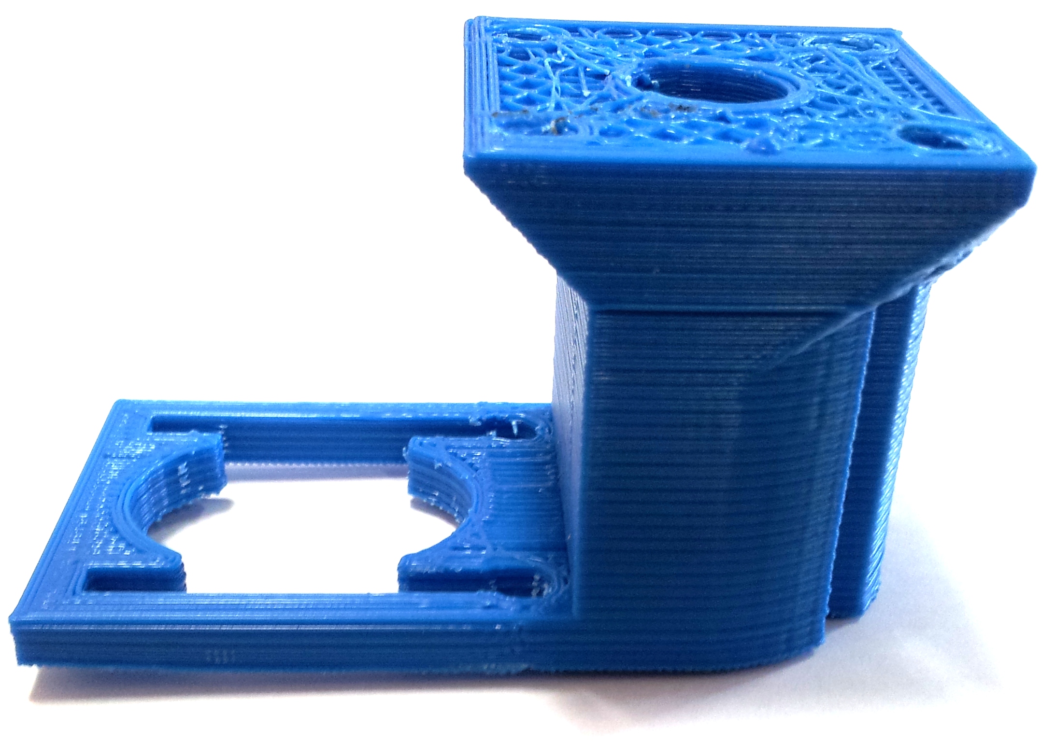
doc/images/failedPrint.jpg
