mossblaser/makebed/doc/images/makerbot_stock.jpg

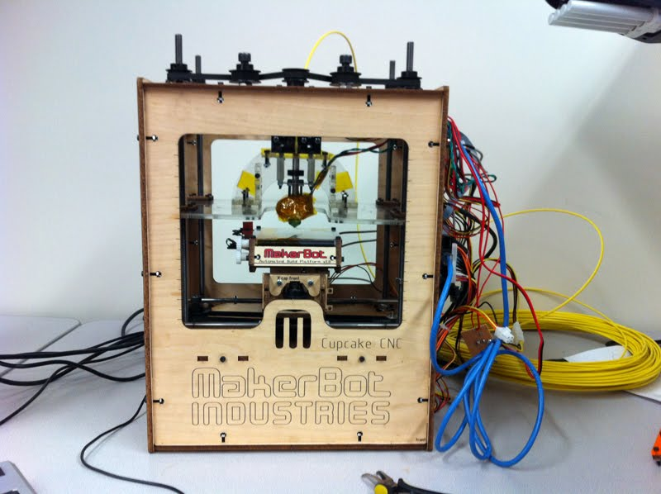
doc/images/makerbot_stock.jpg
