mossblaser/makebed/doc/images/printerControl.png

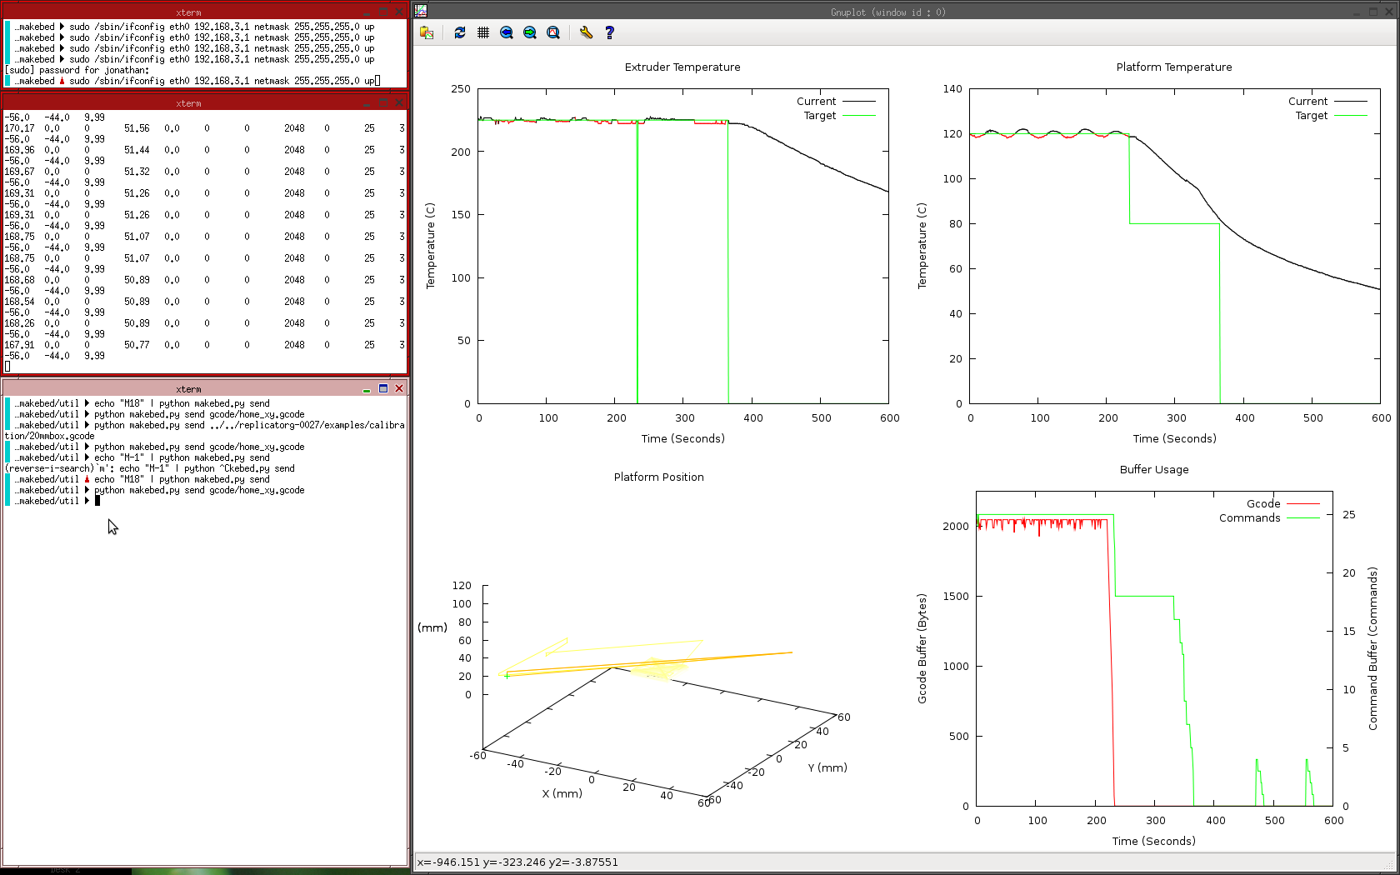
doc/images/printerControl.png
