mossblaser/makebed/doc/diagrams/mosfetPerformance.pdf

Gate-to-Source Voltage (V)

Drain-to-Source Current (A)

1 | 2 | 3 | 4 | 5 | 6 | 7 | 8

0.1

1

10

100

1000

Drain-to-Source
Voltage = 15V
