mossblaser/makebed/doc/images/testCubeOnRaft.jpg

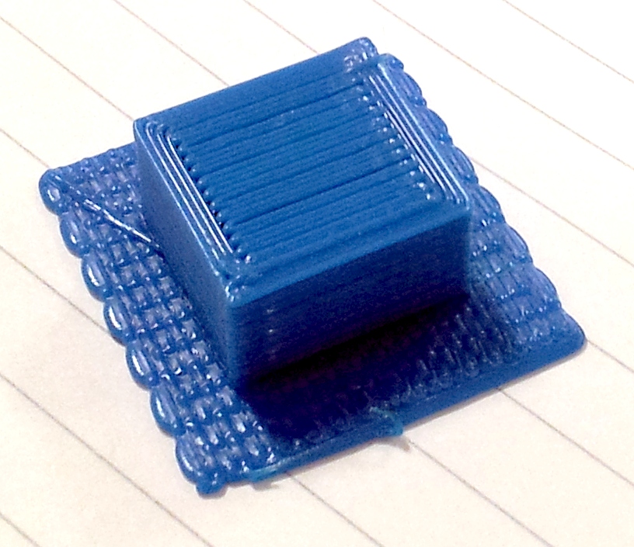
doc/images/testCubeOnRaft.jpg
