mossblaser/makebed/doc/circuits/electronics.pdf

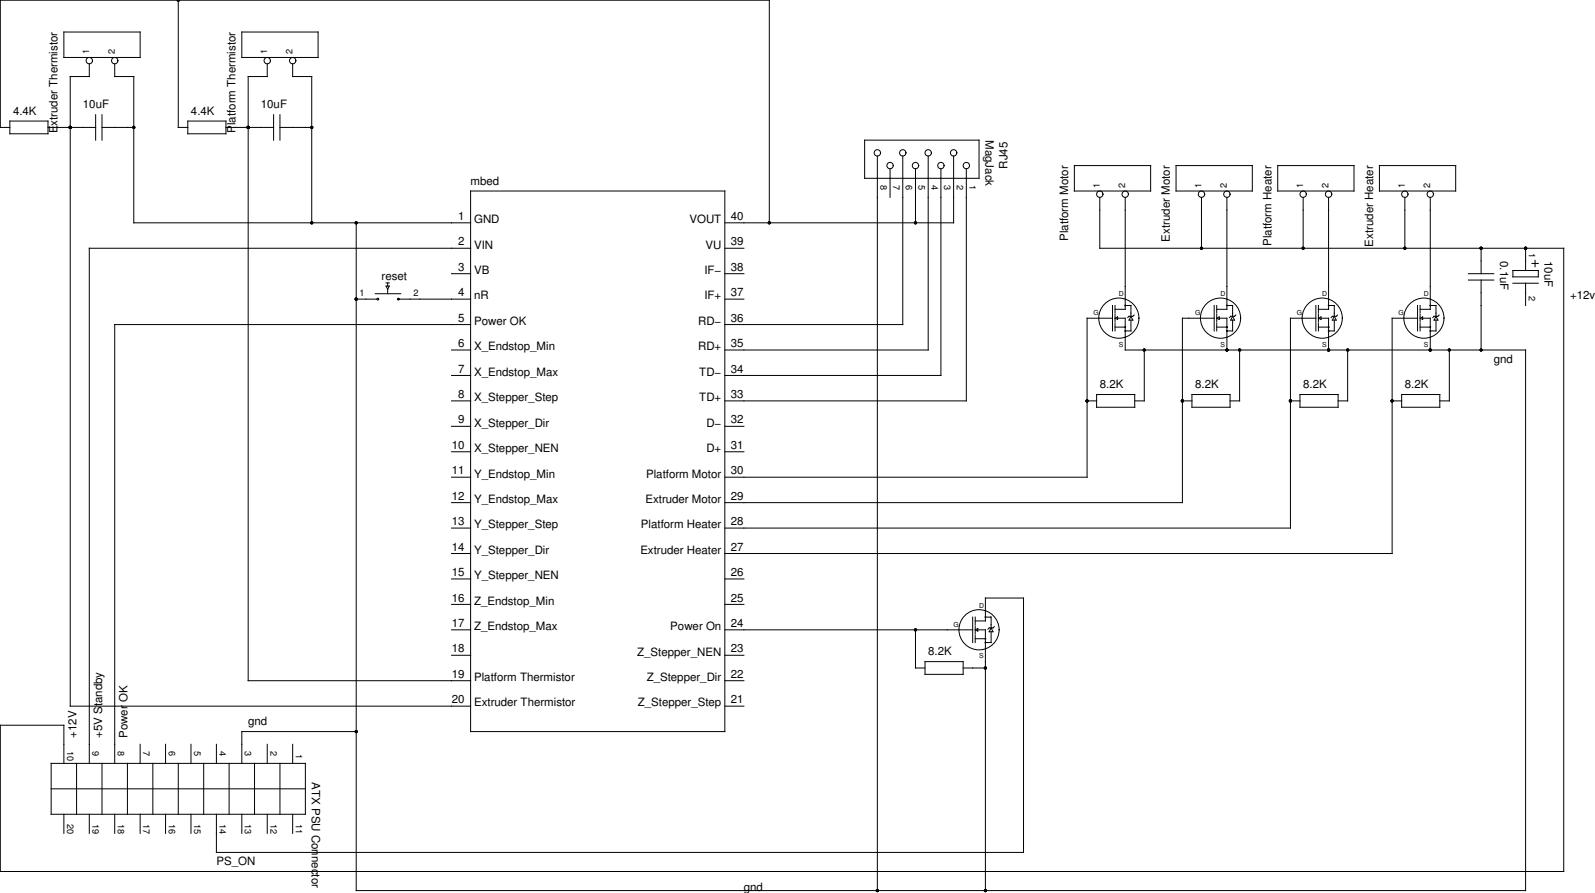
[picture p73: page 1]
GND 2; VIN 3; +5V Standby; Platform Motor; Extruder Motor; Platform Heater; Extruder Heater; Power On; Power OK; Platform Thermistor; Extruder Thermistor; 2 Platform Thermistor; 2 Extruder Thermistor

ATX PSU Connector
