mossblaser/makebed/doc/diagrams/dipBoard.pdf

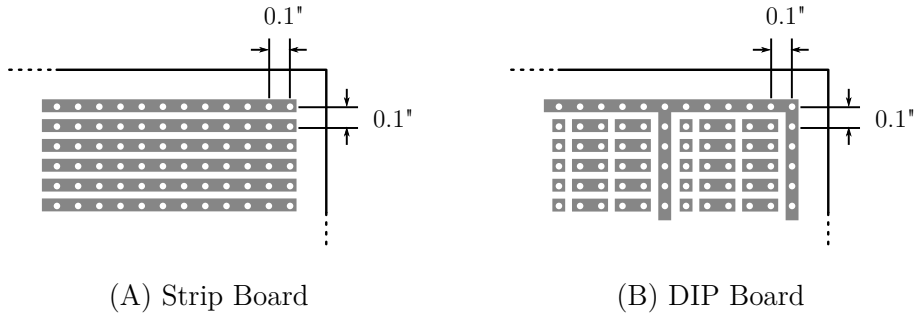
[picture p74: page 1]
(A) Strip Board; (B) DIP Board
