mossblaser/makebed/doc/diagrams/firmwareDiagram.pdf

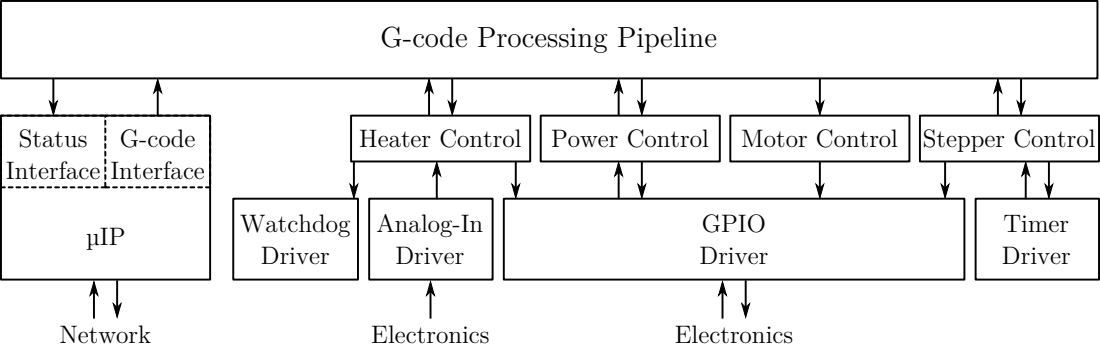
[picture p75: page 1]
Heater Control; Power Control; Motor Control; Stepper Control; Analog-In Driver; GPIO Driver; Watchdog Driver; Timer Driver; µIP; Network; Electronics; Status Interface; G-code Interface

G-code Processing Pipeline
