mossblaser/makebed/doc/diagrams/pid.pdf

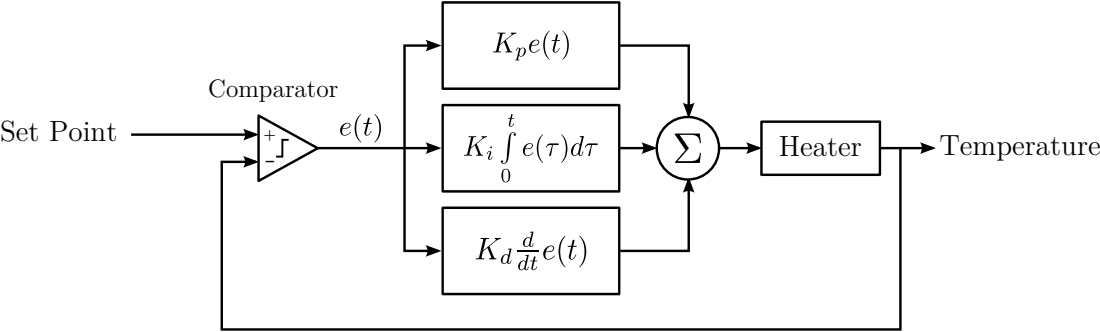
[picture p76: page 1]
Set Point; Comparator +-; Heater; Temperature
