mossblaser/makebed/doc/diagrams/systemDiagramTop.pdf

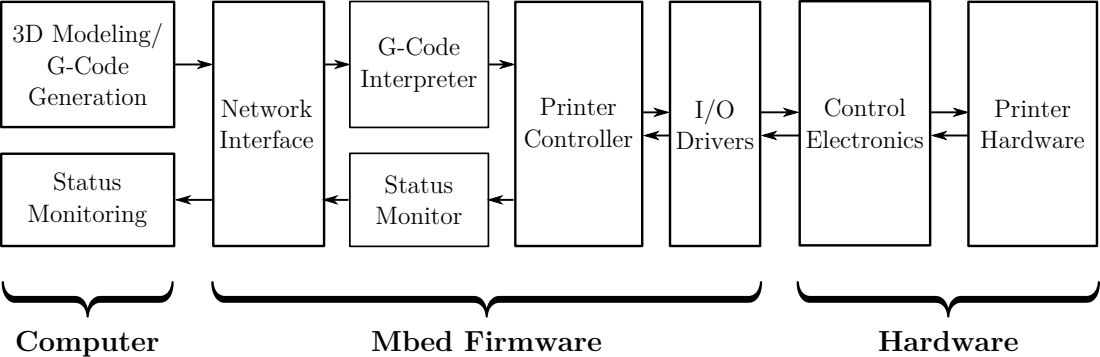
[picture p77: page 1]
3D Modeling/ G-Code Generation; Status Monitoring; Printer Hardware; Control Electronics; Computer; Mbed Firmware; Hardware; Printer Controller; G-Code Interpreter; Network Interface; I/O Drivers; Status Monitor
