mossblaser/makebed/doc/diagrams/printer.pdf

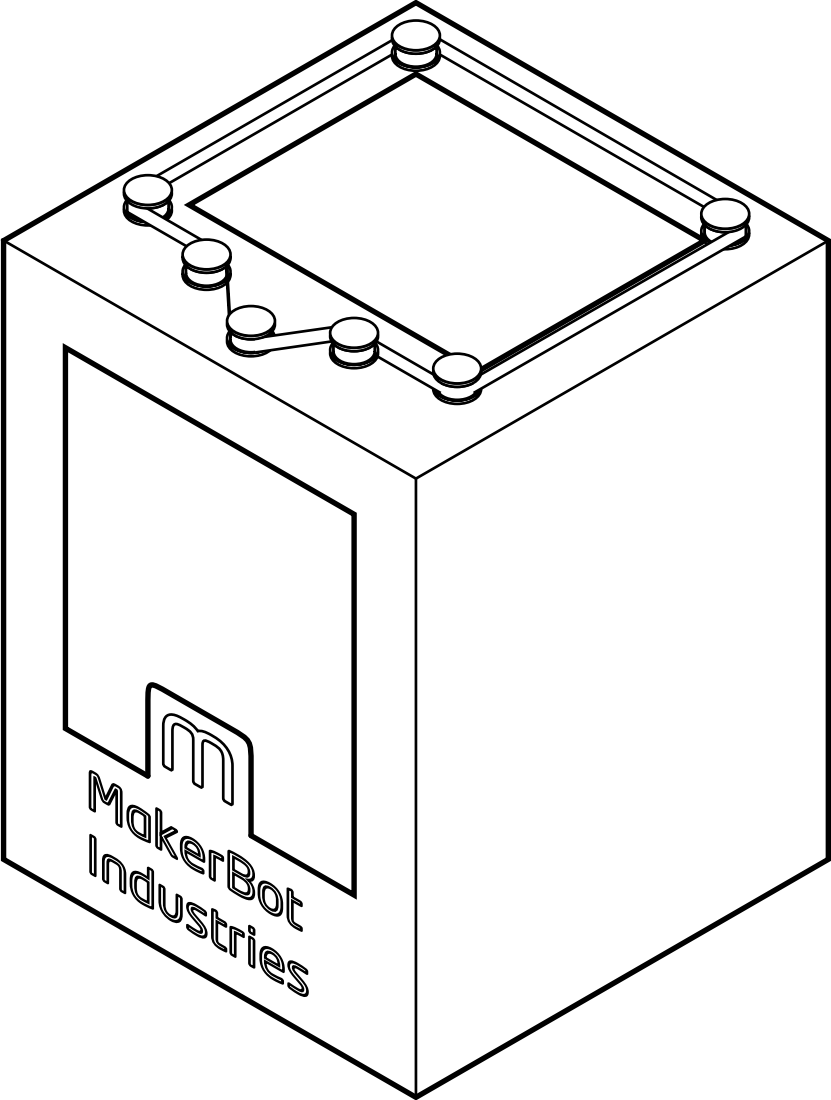
[picture p78: page 1]
