mossblaser/makebed/doc/diagrams/slicing.pdf

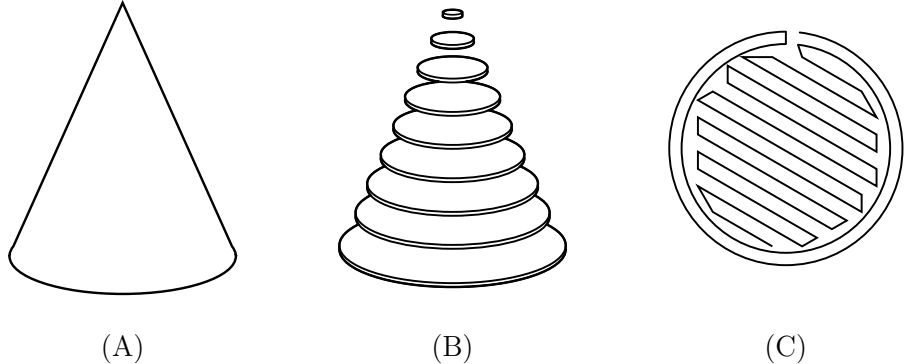
[picture p79: page 1]
