mossblaser/makebed/doc/diagrams/stepperMotor.pdf

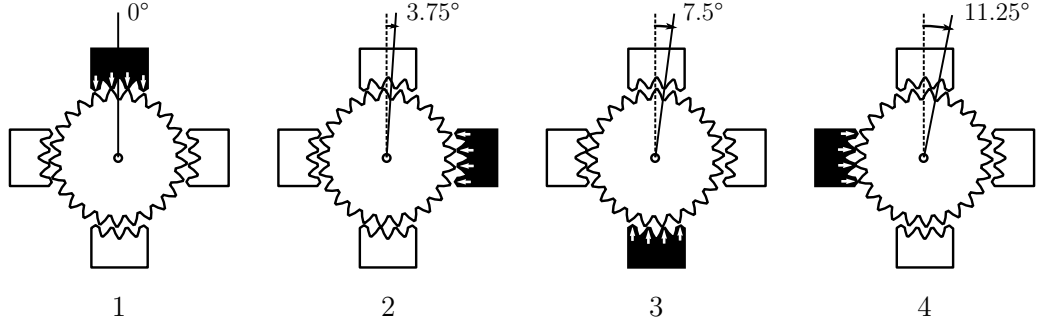
[picture p80: page 1]
