mossblaser/makebed/doc/diagrams/stepperWave.pdf

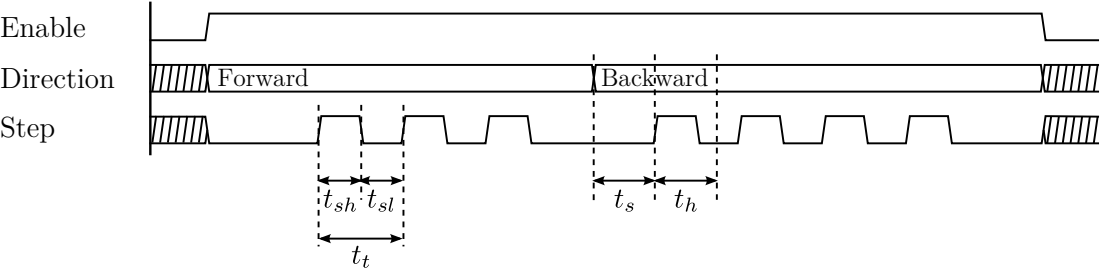
[picture p81: page 1]
Enable; Direction; Step; Forward; Backward
