mossblaser/makebed/doc/circuits/endstop.pdf

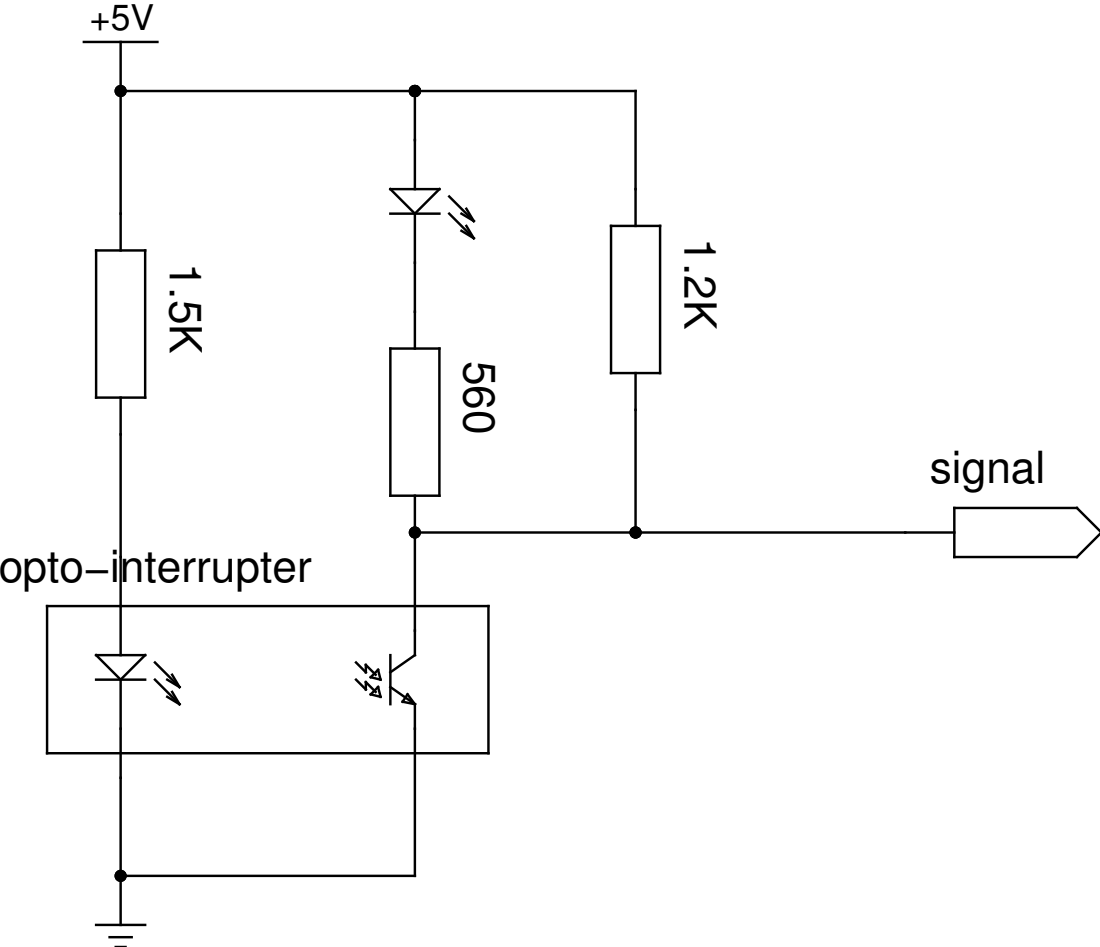
[picture p82: page 1]
