mossblaser/makebed/MakebedConfig.h

/**
 * Parameters, constands and pin allocations for the makebed software.
 */

#ifndef MAKEBED_CONFIG_H
#define MAKEBED_CONFIG_H


/*******************************************************************************
 * General
 ******************************************************************************/
/* Size in bytes of command queue */
#define MAKERBOT_COMMAND_QUEUE_SIZE 1024

/* Size in bytes of the gcode interpreter buffer */
#define GCODE_BUFFER_LENGTH 2048


/*******************************************************************************
 * Network
 ******************************************************************************/
/* Port used to recieve gcode. */
#define NETWORK_PORT_GCODE 1818

/* Port used for debugging. */
#define NETWORK_PORT_DEBUG 2777


/*******************************************************************************
 * Watchdog Falisafe Configuration
 ******************************************************************************/

/* Watchdog feed interval */
#define WATCHDOG_FEED_INTERVAL_MS 2000



/*******************************************************************************
 * Power Control Configuration
 ******************************************************************************/

/* Pin allocations. */

/* Power Enable pin (active high) for the PSU. */
#define PIN_POWER_EN (&gpio_mbed_p24)

/* Signal (active high) from PSU indicating normal power flow. */
#define PIN_POWER_OK (&gpio_mbed_p5)

/* Number of ms to delay after turning the PSU on/off for it to stabalise */
#define MAKERBOT_PSU_DELAY 10



/*******************************************************************************
 * Stepper Motor Control Configuration
 ******************************************************************************/

/* !Enable pins for stepper motors */
#define PIN_STEPPER_0_NEN (&gpio_mbed_p10)
#define PIN_STEPPER_1_NEN (&gpio_mbed_p15)
#define PIN_STEPPER_2_NEN (&gpio_mbed_p23)

/* Direction pins for stepper motors */
#define PIN_STEPPER_0_DIR (&gpio_mbed_p9)
#define PIN_STEPPER_1_DIR (&gpio_mbed_p14)
#define PIN_STEPPER_2_DIR (&gpio_mbed_p22)

/* Enable pins for stepper motors */
#define PIN_STEPPER_0_STEP (&gpio_mbed_p8)
#define PIN_STEPPER_1_STEP (&gpio_mbed_p13)
#define PIN_STEPPER_2_STEP (&gpio_mbed_p21)

/* Which steppers direction should be inverted? */
#define STEPPER_0_INVERTED false
#define STEPPER_1_INVERTED true
#define STEPPER_2_INVERTED false

/* Should endstops be used?? */
#define USE_ENDSTOPS true

/* Endstops are active high? */
#define ENDSTOP_ACTIVE_HIGH false

/* End-stop pins */
#define PIN_ENDSTOP_0_MIN (&gpio_mbed_p6)
#define PIN_ENDSTOP_1_MIN (&gpio_mbed_p11)
#define PIN_ENDSTOP_2_MIN (&gpio_mbed_p16)

#define PIN_ENDSTOP_0_MAX (&gpio_mbed_p7)
#define PIN_ENDSTOP_1_MAX (&gpio_mbed_p12)
#define PIN_ENDSTOP_2_MAX (&gpio_mbed_p17)

/* End-stop positions */
#define ENDSTOP_0_MIN_POS 0.0
#define ENDSTOP_1_MIN_POS 0.0
#define ENDSTOP_2_MIN_POS 0.0

#define ENDSTOP_0_MAX_POS 46.0
#define ENDSTOP_1_MAX_POS 43.0
#define ENDSTOP_2_MAX_POS 0.0


/* Stepper controler parameters. */

/* How many steppers will be managed? */
#define STEPPER_NUM_MOTORS 3

/* Which system timer should be used for stepper control (0-3) */
#define STEPPER_TIMER_NO 1

/* The frequency at which the timer increments (Hz) */
#define STEPPER_TIMER_HZ 1000000

/* When the ISR runs, how far long should transitions be dealt with (ns). This
 * will probably be at least the amount of time you estimate the ISR takes to
 * enter, execute and leave. If this is too short the timer will be set for some
 * time so soon in the future it will have already passed by the time the ISR is
 * finished and so the whole thing breaks. */
#define STEPPER_MERGE_WINDOW_NS 1000000ul

/* The hold time in ns of the direction/enable signals of a stepper controller */
#define STEPPER_HOLD_NS 200

/* Calibration steps/mm data */
#define STEPPER_0_STEPS_PER_MM 12
#define STEPPER_1_STEPS_PER_MM 12
#define STEPPER_2_STEPS_PER_MM 333.33333

/* Minimum Step Period for Steppers */
#define STEPPER_MIN_PERIOD ((int)((1.0/555.5555) * ((double)STEPPER_TIMER_HZ)))

/* Period between steps for homing */
#define STEPPER_HOME_PERIOD (STEPPER_MIN_PERIOD * 4)


/*******************************************************************************
 * Heater/Temperature Control Configuration
 ******************************************************************************/

/* Temperature Probe Pins */
#define PIN_THERMISTOR_PLATFORM (&analog_in_mbed_p19)
#define PIN_THERMISTOR_EXTRUDER (&analog_in_mbed_p20)

/* Heater Pins */
#define PIN_HEATER_PLATFORM (&gpio_mbed_p28)
#define PIN_HEATER_EXTRUDER (&gpio_mbed_p27)

/* LED Pins */
#define PIN_LED_PLATFORM (&gpio_mbed_led2)
#define PIN_LED_EXTRUDER (&gpio_mbed_led3)

/* Thermistor Calibration Data */
#define THERMISTOR_PLATFORM_V_VREF 3.3
#define THERMISTOR_PLATFORM_R      4400.0
#define THERMISTOR_PLATFORM_R0     100000.0
#define THERMISTOR_PLATFORM_B      4072.0
#define THERMISTOR_PLATFORM_T0     (25.0 + 273.15)

#define THERMISTOR_EXTRUDER_V_VREF 3.3
#define THERMISTOR_EXTRUDER_R      4400.0
#define THERMISTOR_EXTRUDER_R0     100000.0
#define THERMISTOR_EXTRUDER_B      4072.0
#define THERMISTOR_EXTRUDER_T0     (25.0 + 273.15)

/* PID */
#define THERMISTOR_EXTRUDER_P 7.0
#define THERMISTOR_EXTRUDER_I 0.0
#define THERMISTOR_EXTRUDER_D 50.0

#define THERMISTOR_PLATFORM_P 7.0
#define THERMISTOR_PLATFORM_I 0.342
#define THERMISTOR_PLATFORM_D 36.0



/*******************************************************************************
 * Extruder
 ******************************************************************************/

/* Pin */
#define PIN_EXTRUDER (&gpio_mbed_p29)



/*******************************************************************************
 * Automated Build Platform
 ******************************************************************************/

/* Pin */
#define PIN_PLATFORM (&gpio_mbed_p30)


#endif
