mossblaser/makebed/(commit log)

2011-10-13 Compiles but doesn't link.
    [gpio.c, gpio.h, main.c]
2011-11-01 Allowed LED1 on p1.18 to be GPIO controled
2011-11-22 Added stepper control.
2011-11-23 Added stepper system
2011-11-23 Switched stepper timer to timer 1 as timer 0 in use, fixed timer switching.
    [MakebedConfig.h, main.c, stepper.c, stepper.h]
2011-11-29 Fixed analog read overwriting PINSEL register.
    [analog_in.c]
2011-11-30 Added watchdog timer
2011-12-01 Added thermistor reading
2012-02-03 Added temperature demo.
2012-02-06 Added command buffering for makerbot. Prints a square
2012-02-09 Circle printing
2012-02-10 Oops! Forgot to commit PID from *ages* ago!
2012-02-22 Added TCP debugging and Gcode interface (prototype)
2012-02-24 Gcode printing with flow control functional but flowcontrol non-optimal.
2012-02-28 Removed duplicate transmission for all frames.
2012-02-29 Added missing platform mcode
    [makerbot.c]
2012-03-05 Fixed stepper directions
2012-03-07 Added UDP retransmit and stepper speed limiting.
2012-03-19 Extended gcode with power on/off and stepper power on/off.
2012-03-19 Added AR's PID values.
2012-03-19 PID Tuning It 1
2012-03-20 Set PID values back to ARs values.
2012-03-22 Added endstop pins to config.
2012-03-23 Added basic endstop homing (untested).
2012-03-25 Added initial report framework.
2012-03-25 Added endstop calibration.
2012-03-27 Moved stepper/heater control into driver block in firmware diagram.
2012-04-04 Added temperature control section.
2012-04-11 PID and networking testing.
2012-04-19 Fixed citation name case.
2012-04-19 Added example print gallery.
2012-04-20 Added electronics appendix.
    [Electronics.sch, Endstop.sch]
2012-04-20 Added figures to example printing process.
2012-04-25 Fixed appendix 3.
    [Electronics.sch]
